ElectronicCats/PWNCUBE/ground-station/pwnsatc3/app/static/assets/Tapa-Body.stl

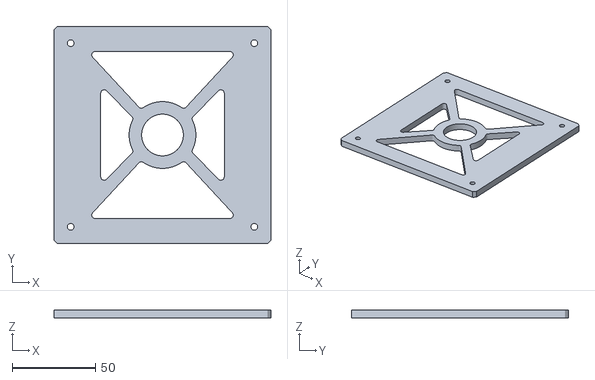
[picture p4: CAD file, 2026-04-01]
ground-station/pwnsatc3/app/static/assets/Tapa-Body.stl
130.0 x 130.0 x 5.00
