ElectronicCats/PWNCUBE/hardware/Battery_Board/3D/SAMTEC_SMA-J-P-H-ST-EM1.STEP

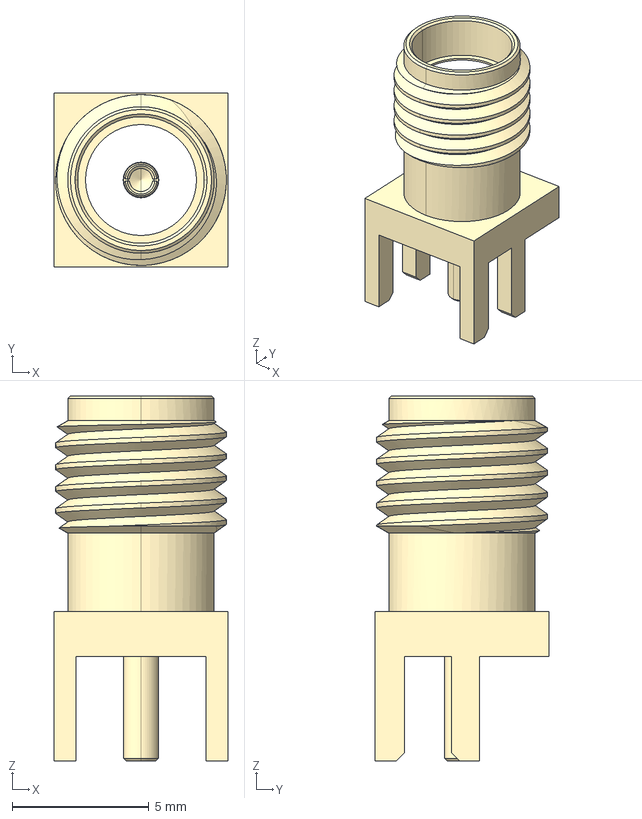
[picture p5: CAD file, 2026-02-04]
hardware/Battery_Board/3D/SAMTEC_SMA-J-P-H-ST-EM1.STEP
6.35 x 6.35 x 13.3 mm
