ElectronicCats/PWNCUBE/hardware/PWNSAT/3D/antenna_915Mhz-antenna_915Mhz.step

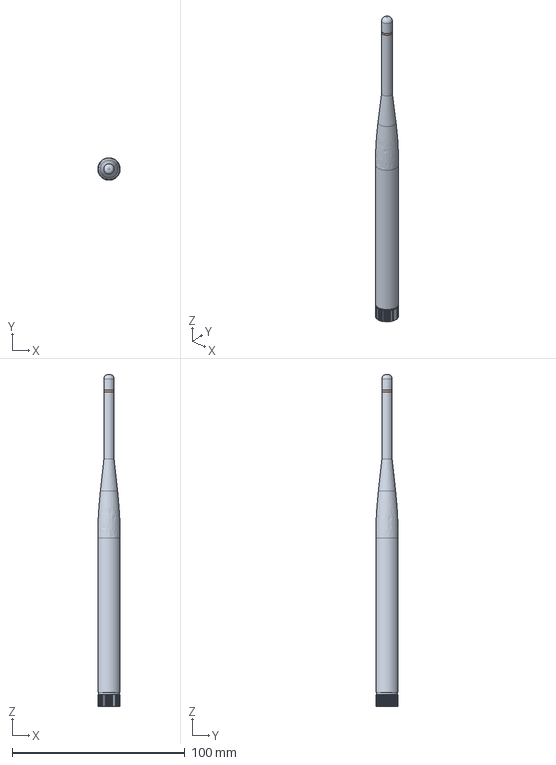
[picture p6: CAD file, 2026-02-04]
hardware/PWNSAT/3D/antenna_915Mhz-antenna_915Mhz.step
13.0 x 13.0 x 192.0 mm
