ElectronicCats/PWNCUBE/hardware/Sensor_Board/3D/USB4105-GF-A.stp

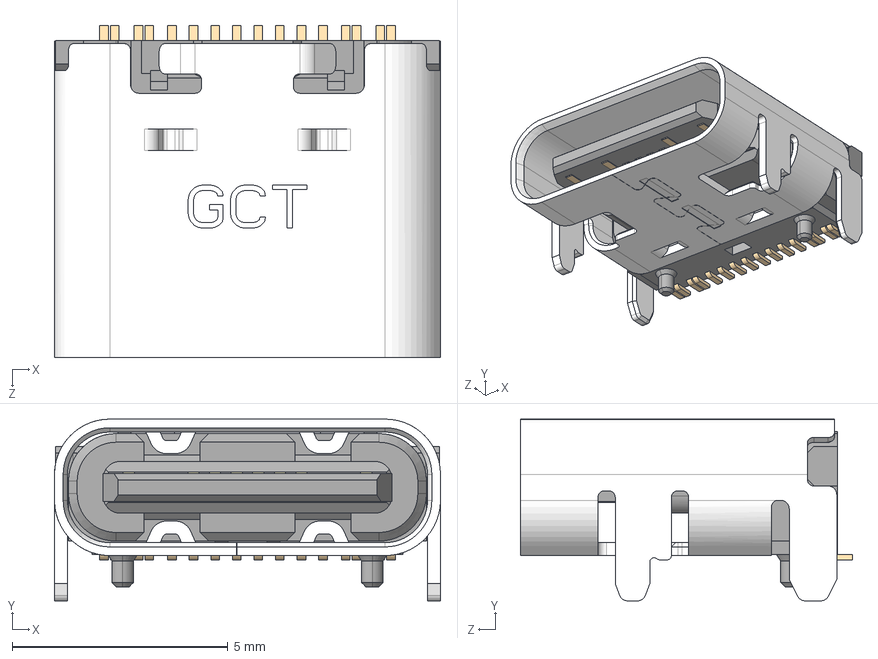
[picture p7: CAD file, 2026-02-04]
hardware/Sensor_Board/3D/USB4105-GF-A.stp
8.94 x 4.21 x 7.70 mm
HSG_默认
