ElectronicCats/PWNCUBE/hardware/Battery_Board/3D/TS-1088R-02526.STEP

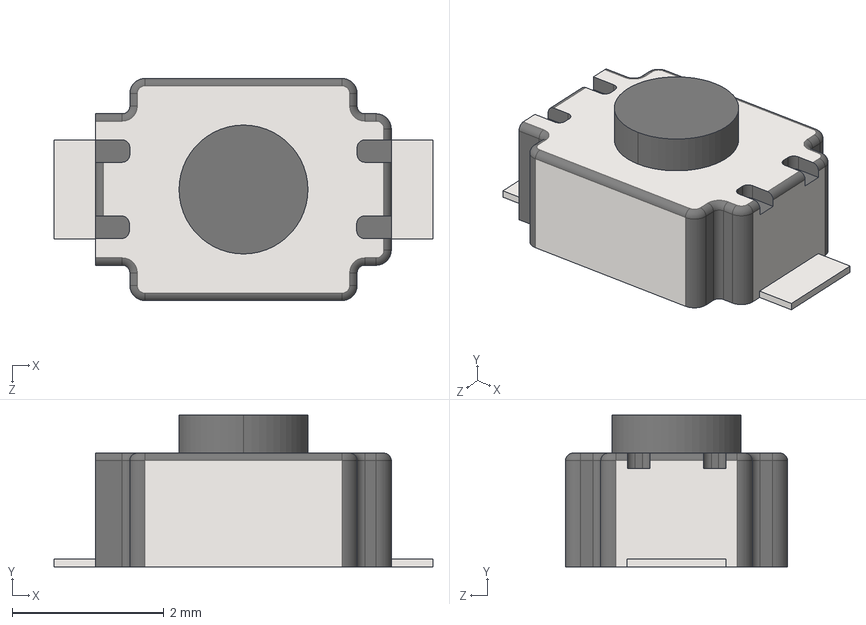
[picture p8: CAD file, 2026-02-04]
hardware/Battery_Board/3D/TS-1088R-02526.STEP
5.00 x 2.00 x 2.93 mm
