ElectronicCats/PWNCUBE/hardware/PWNSAT/3D/0900PC15A0036E--3DModel-STEP-56544.STEP

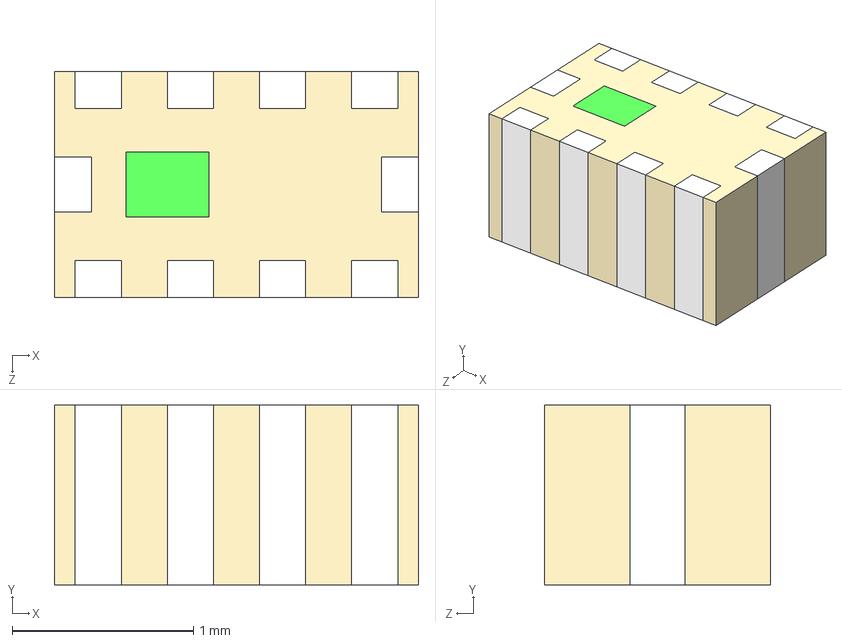
[picture p9: CAD file, 2026-02-04]
hardware/PWNSAT/3D/0900PC15A0036E--3DModel-STEP-56544.STEP
2.01 x 0.991 x 1.24 mm
