ElectronicCats/PWNCUBE/hardware/PWNSAT/3D/CMUSB661022B.stp

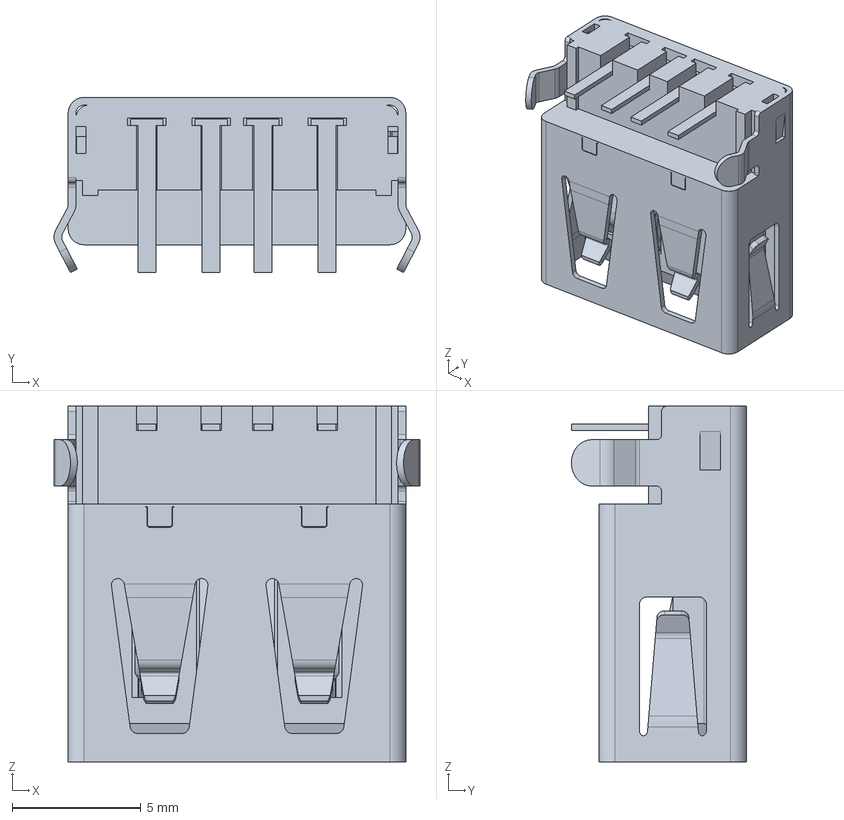
[picture p10: CAD file, 2026-02-04]
hardware/PWNSAT/3D/CMUSB661022B.stp
14.2 x 6.80 x 13.8 mm
