ElectronicCats/PWNCUBE/hardware/PWNSAT/3D/User Library-qfn-128.STEP

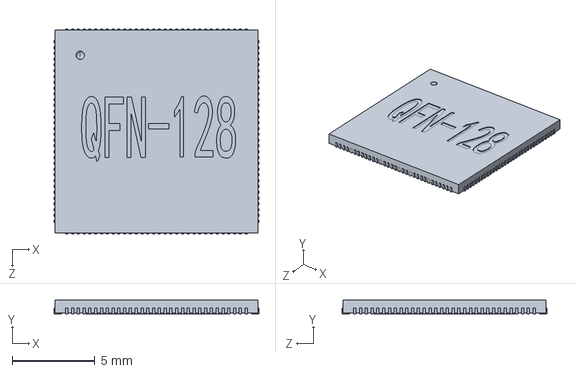
[picture p11: CAD file, 2026-02-04]
hardware/PWNSAT/3D/User Library-qfn-128.STEP
12.4 x 0.85 x 12.4 mm
