ElectronicCats/PWNCUBE/hardware/PWNSAT/3D/W25Q01JVZEIQ.STEP

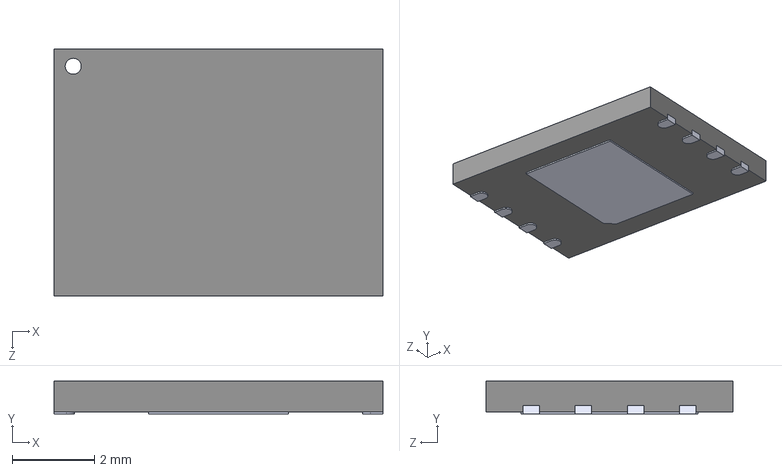
[picture p12: CAD file, 2026-02-04]
hardware/PWNSAT/3D/W25Q01JVZEIQ.STEP
8.00 x 0.8 x 6.00 mm
