ElectronicCats/PWNCUBE/hardware/PWNSAT/3D/1001-001-01000.igs

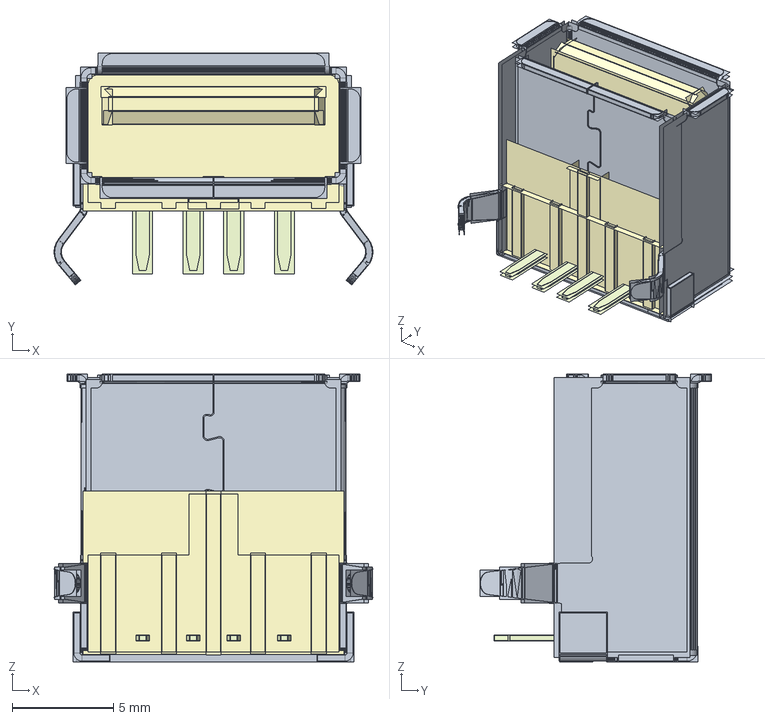
[picture p13: CAD file, 2026-02-04]
hardware/PWNSAT/3D/1001-001-01000.igs
15.8 x 11.5 x 14.2 mm
