ElectronicCats/PWNCUBE/hardware/PWNSAT/PWNSAT.kicad_pcb

## KiCad design hardware/PWNSAT/PWNSAT.kicad_pcb (2026-03-17)

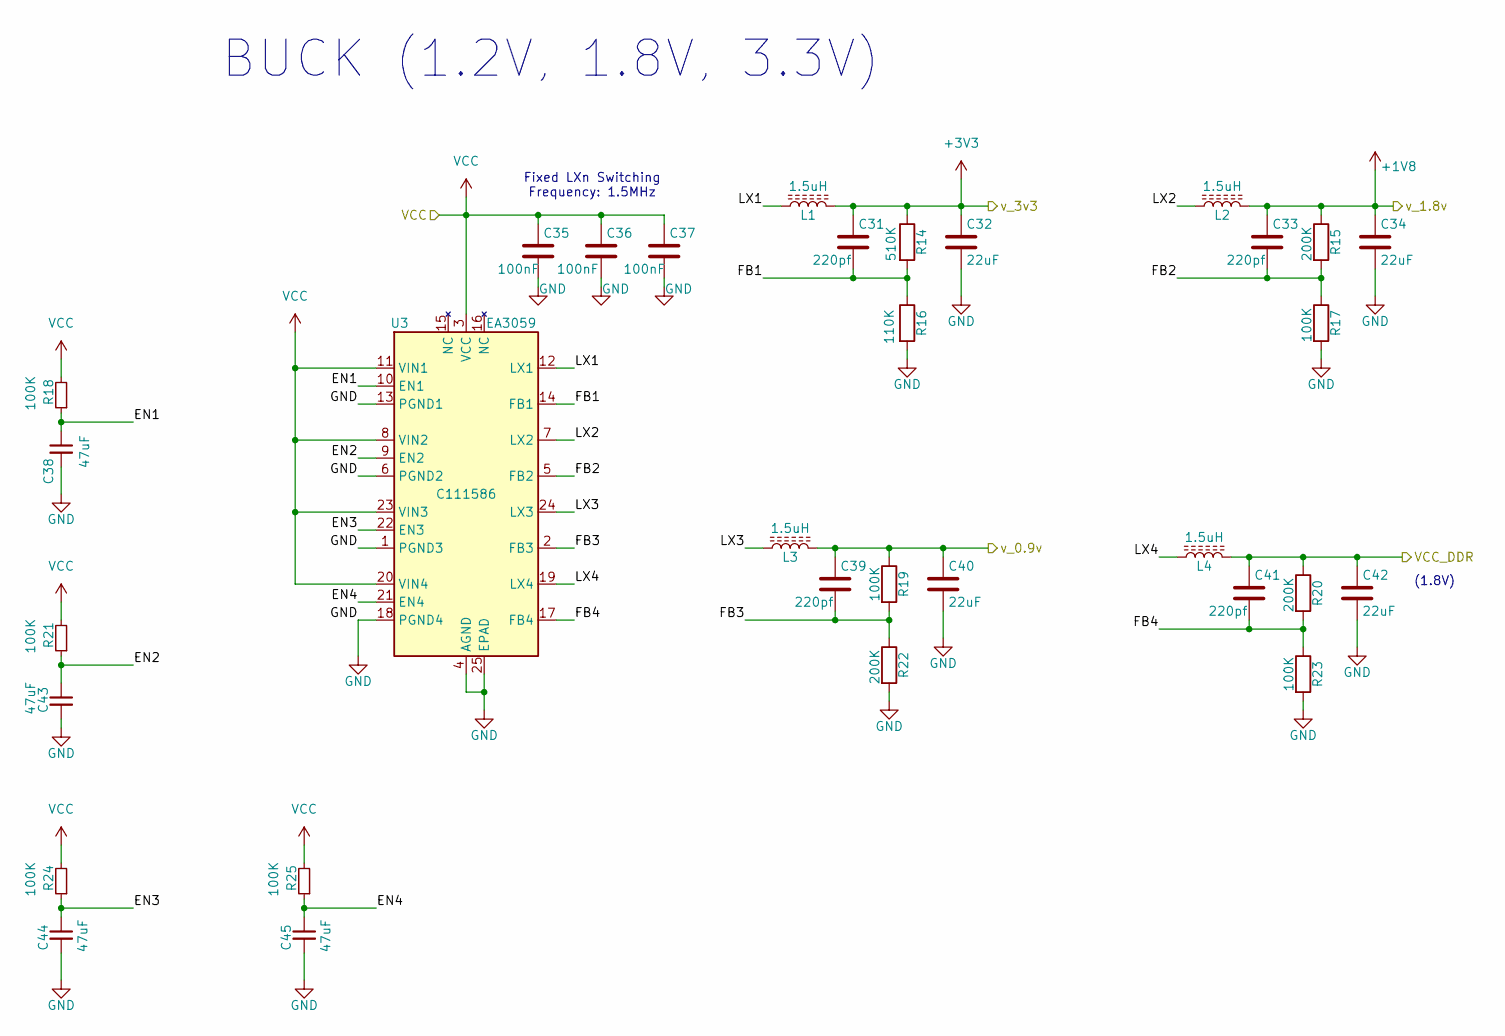
[picture p14: schematic power_supply.kicad_sch, PWNCube]

Parts:
C31, C33, C39, C41: 220pf; C_0402_1005Metric_Pad0.74x0.62mm_HandSolder; LCSC# C327000
C32, C34, C40, C42: 22uF; C_0402_1005Metric; LCSC# C415703
C35, C36, C37: 100nF; C_0402_1005Metric_Pad0.74x0.62mm_HandSolder; LCSC# C56392
C38, C43, C44, C45: 47uF; C_0603_1608Metric; LCSC# C140782
L1, L2, L3, L4: 1.5uH; L_1008_2520Metric; LCSC# C7427193
R14: 510K; R_0402_1005Metric_Pad0.72x0.64mm_HandSolder; LCSC# C365024
R15, R20, R22: 200K; R_0402_1005Metric_Pad0.72x0.64mm_HandSolder; LCSC# C364966
R16: 110K; R_0402_1005Metric_Pad0.72x0.64mm_HandSolder; LCSC# C854086
R17, R18, R19, R21, R23, R24, R25: 100K; R_0402_1005Metric_Pad0.72x0.64mm_HandSolder; LCSC# C844674
U3: EA3059; VQFN-24-1EP_4x4mm_P0.5mm_EP2.5x2.5mm; LCSC# C111586

Connections:
+1V8: C33.1, C34.1, L2.2, R15.1; also elsewhere on the board
+3V3: C31.1, C32.1, L1.2, R14.1; also elsewhere on the board
/core/VCC_DDR: C41.1, C42.1, L4.2, R20.1; also elsewhere on the board
/core/VDD_ARM: C39.1, C40.1, L3.2, R19.1; also elsewhere on the board
/power_supply/EN1: C38.1, R18.1, U3.10 (EN1)
/power_supply/EN2: C43.1, R21.1, U3.9 (EN2)
/power_supply/EN3: C44.1, R24.1, U3.22 (EN3)
/power_supply/EN4: C45.1, R25.1, U3.21 (EN4)
/power_supply/FB1: C31.2, R14.2, R16.1, U3.14 (FB1)
/power_supply/FB2: C33.2, R15.2, R17.1, U3.5 (FB2)
/power_supply/FB3: C39.2, R19.2, R22.1, U3.2 (FB3)
/power_supply/FB4: C41.2, R20.2, R23.1, U3.17 (FB4)
/power_supply/LX1: L1.1, U3.12 (LX1)
/power_supply/LX2: L2.1, U3.7 (LX2)
/power_supply/LX3: L3.1, U3.24 (LX3)
/power_supply/LX4: L4.1, U3.19 (LX4)
GND: C32.2, C34.2, C35.2, C36.2, C37.2, C38.2, C40.2, C42.2, C43.2, C44.2, C45.2, R16.2, R17.2, R22.2, R23.2, U3.1 (PGND3), U3.4 (AGND), U3.6 (PGND2), U3.13 (PGND1), U3.18 (PGND4), U3.25 (EPAD); also elsewhere on the board
VCC: C35.1, C36.1, C37.1, R18.2, R21.2, R24.2, R25.2, U3.3 (VCC), U3.8 (VIN2), U3.11 (VIN1), U3.20 (VIN4), U3.23 (VIN3); also elsewhere on the board

Notes on the sheet:
BUCK (1.2V, 1.8V, 3.3V)
Fixed LXn Switching Frequency: 1.5MHz
(1.8V)

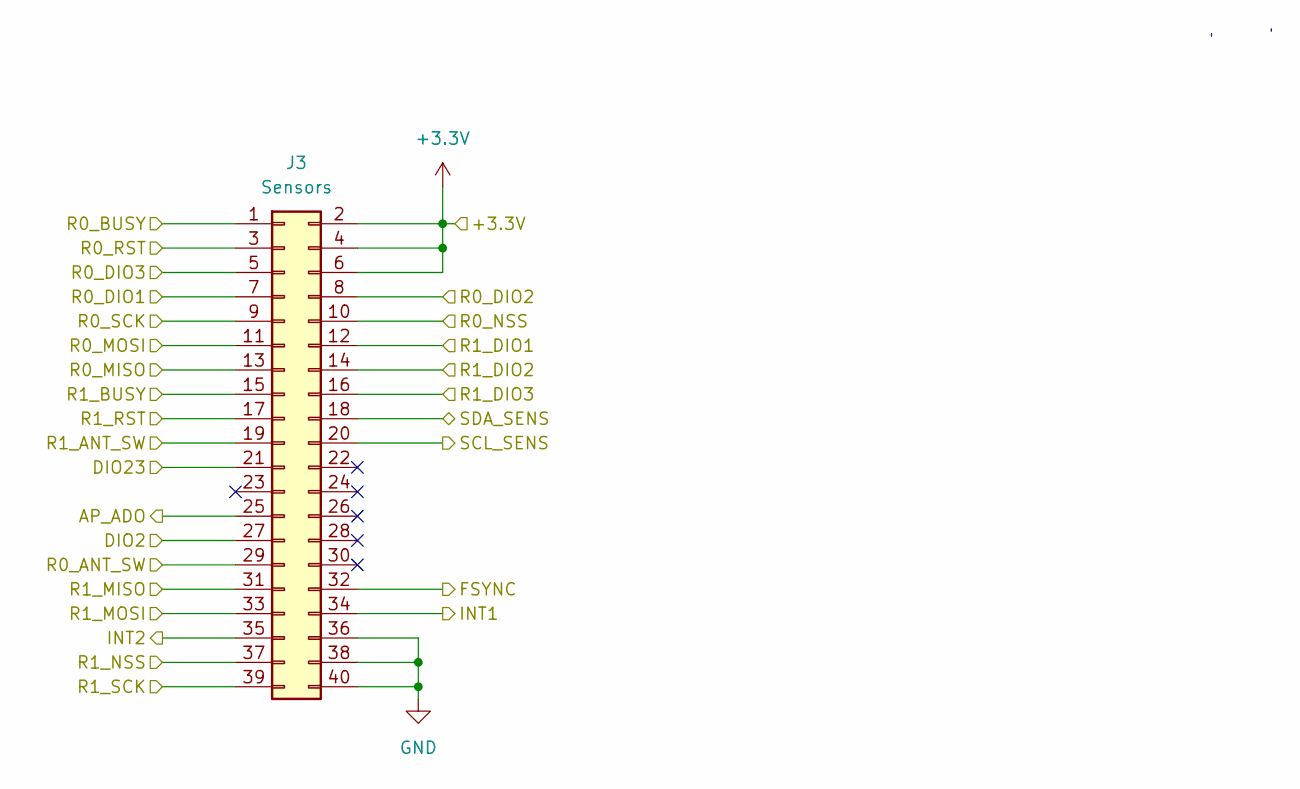
[picture p15: schematic sensor.kicad_sch, PWNCube]

Parts:
J3: Sensors; PinHeader_2x20_P2.54mm_Vertical; LCSC# C7501249

Connections:
+3.3V: J3.2, J3.4, J3.6; also elsewhere on the board
/Sensor/AP_ADO: J3.25; also elsewhere on the board
/Sensor/DIO2: J3.27; also elsewhere on the board
/Sensor/DIO23: J3.21; also elsewhere on the board
/Sensor/FSYNC: J3.32; also elsewhere on the board
/Sensor/INT1: J3.34; also elsewhere on the board
/Sensor/INT2: J3.35; also elsewhere on the board
/Sensor/R0_ANT_SW: J3.29; also elsewhere on the board
/Sensor/R0_BUSY: J3.1; also elsewhere on the board
/Sensor/R0_DIO1: J3.7; also elsewhere on the board
/Sensor/R0_DIO2: J3.8; also elsewhere on the board
/Sensor/R0_DIO3: J3.5; also elsewhere on the board
/Sensor/R0_MISO: J3.13; also elsewhere on the board
/Sensor/R0_MOSI: J3.11; also elsewhere on the board
/Sensor/R0_NSS: J3.10; also elsewhere on the board
/Sensor/R0_RST: J3.3; also elsewhere on the board
/Sensor/R0_SCK: J3.9; also elsewhere on the board
/Sensor/R1_ANT_SW: J3.19; also elsewhere on the board
/Sensor/R1_BUSY: J3.15; also elsewhere on the board
/Sensor/R1_DIO1: J3.12; also elsewhere on the board
/Sensor/R1_DIO2: J3.14; also elsewhere on the board
/Sensor/R1_DIO3: J3.16; also elsewhere on the board
/Sensor/R1_MISO: J3.31; also elsewhere on the board
/Sensor/R1_MOSI: J3.33; also elsewhere on the board
/Sensor/R1_NSS: J3.37; also elsewhere on the board
/Sensor/R1_RST: J3.17; also elsewhere on the board
/Sensor/R1_SCK: J3.39; also elsewhere on the board
/Sensor/SCL_SENS: J3.20; also elsewhere on the board
/Sensor/SDA_SENS: J3.18; also elsewhere on the board
GND: J3.36, J3.38, J3.40; also elsewhere on the board

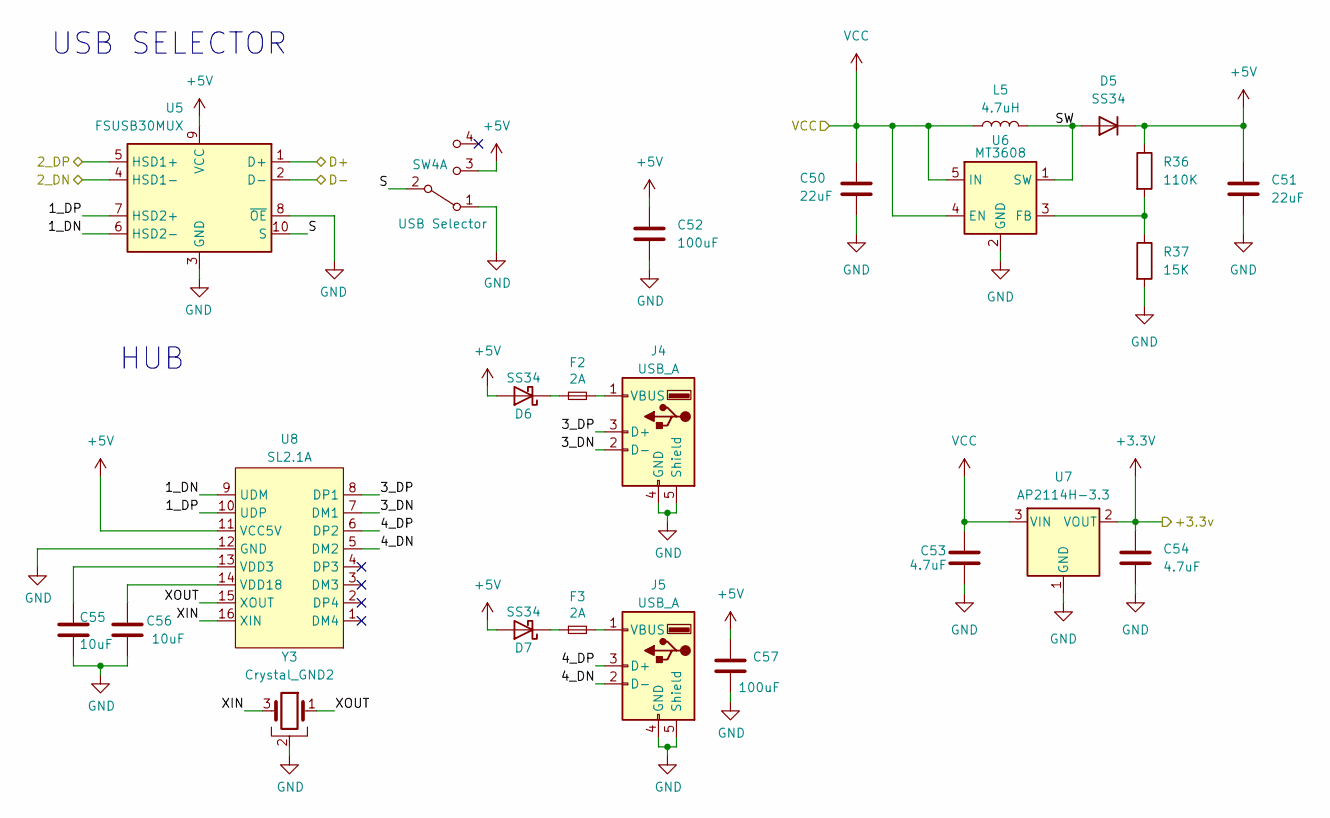
[picture p16: schematic USB_Selector.kicad_sch, PWNCube]

Parts:
C50, C51: 22uF; C_0402_1005Metric; LCSC# C415703
C52, C57: 100uF; C_0805_2012Metric; LCSC# C141660
C53, C54: 4.7uF; C_0402_1005Metric; LCSC# C368809
C55, C56: 10uF; C_0603_1608Metric; LCSC# C96446
D5, D6, D7: SS34; D_SMA; LCSC# C908680
F2, F3: 2A; Fuse_0603_1608Metric; LCSC# C41380229
J4, J5: USB_A; USB_A_Connfly_DS1095; LCSC# C2345
L5: 4.7uH; LQH5BPN; LCSC# C520334
R36: 110K; R_0603_1608Metric; LCSC# C326736
R37: 15K; R_0603_1608Metric; LCSC# C2989599
SW4: USB Selector; SW_Slide_SPDT_Angled_CK_OS102011MA1Q; LCSC# C393937
U5: FSUSB30MUX; IC_FSUSB42UMX; LCSC# C42370490
U6: MT3608; SOT-23-6; LCSC# C2932326
U7: AP2114H-3.3; SOT-223-3_TabPin2; LCSC# C150716
U8: SL2.1A; SO-16_3.9x9.9mm_P1.27mm; LCSC# C192893
Y3: Crystal_GND2; Crystal_SMD_3225-4Pin_3.2x2.5mm; LCSC# C133334

Connections:
+3.3V: C54.1, U7.2 (VOUT); also elsewhere on the board
+5V: C51.1, C52.1, C57.1, D5.1 (K), D6.2 (A), D7.2 (A), R36.1, SW4.3 (C), U5.9 (VCC), U8.11 (VCC5V)
/Source_Connector/2_DN: U5.4 (HSD1-); also elsewhere on the board
/Source_Connector/2_DP: U5.5 (HSD1+); also elsewhere on the board
/USB_Selector/1_DN: U5.6 (HSD2-), U8.9 (UDM)
/USB_Selector/1_DP: U5.7 (HSD2+), U8.10 (UDP)
/USB_Selector/3_DN: J4.2 (D-), U8.7 (DM1)
/USB_Selector/3_DP: J4.3 (D+), U8.8 (DP1)
/USB_Selector/4_DN: J5.2 (D-), U8.5 (DM2)
/USB_Selector/4_DP: J5.3 (D+), U8.6 (DP2)
/USB_Selector/D+: U5.1 (D+); also elsewhere on the board
/USB_Selector/D-: U5.2 (D-); also elsewhere on the board
/USB_Selector/S: SW4.2 (B), U5.10 (S)
/USB_Selector/SW: D5.2 (A), L5.2, U6.1 (SW)
/USB_Selector/XIN: U8.16 (XIN), Y3.3
/USB_Selector/XOUT: U8.15 (XOUT), Y3.1
GND: C50.2, C51.2, C52.2, C53.2, C54.2, C55.2, C56.1, C57.2, J4.4 (GND), J4.5 (Shield), J5.4 (GND), J5.5 (Shield), R37.2, SW4.1 (A), U5.3 (GND), U5.8 (~OE), U6.2 (GND), U7.1 (GND), U8.12 (GND), Y3.2, Y3.4; also elsewhere on the board
unnamed: D6.1 (K), F2.1
unnamed: D7.1 (K), F3.1
unnamed: F2.2, J4.1 (VBUS)
unnamed: F3.2, J5.1 (VBUS)
unnamed: R36.2, R37.1, U6.3 (FB)
unnamed: C55.1, U8.13 (VDD3)
unnamed: C56.2, U8.14 (VDD18)
VCC: C50.1, C53.1, L5.1, U6.4 (EN), U6.5 (IN), U7.3 (VIN); also elsewhere on the board

Notes on the sheet:
HUB
USB SELECTOR

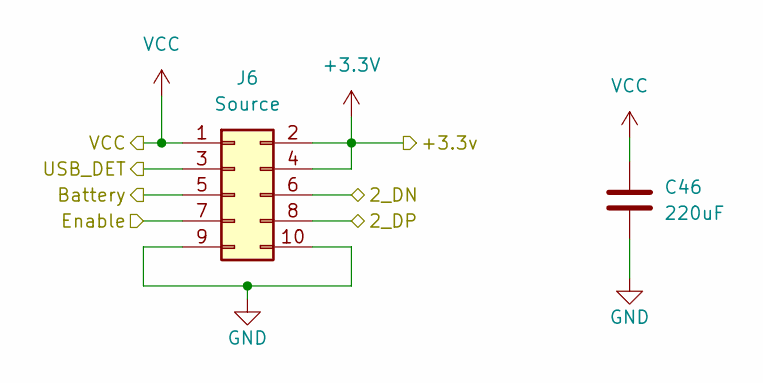
[picture p17: schematic Source_Connector.kicad_sch, PWNCube]

Parts:
C46: 220uF; C_1206_3216Metric
J6: Source; PinHeader_2x05_P2.54mm_Vertical; LCSC# C7501191

Connections:
+3.3V: J6.2, J6.4; also elsewhere on the board
/Source_Connector/2_DN: J6.6; also elsewhere on the board
/Source_Connector/2_DP: J6.8; also elsewhere on the board
/Source_Connector/Battery: J6.5; also elsewhere on the board
/Source_Connector/Enable: J6.7; also elsewhere on the board
/Source_Connector/USB_DET: J6.3; also elsewhere on the board
GND: C46.2, J6.9, J6.10; also elsewhere on the board
VCC: C46.1, J6.1; also elsewhere on the board

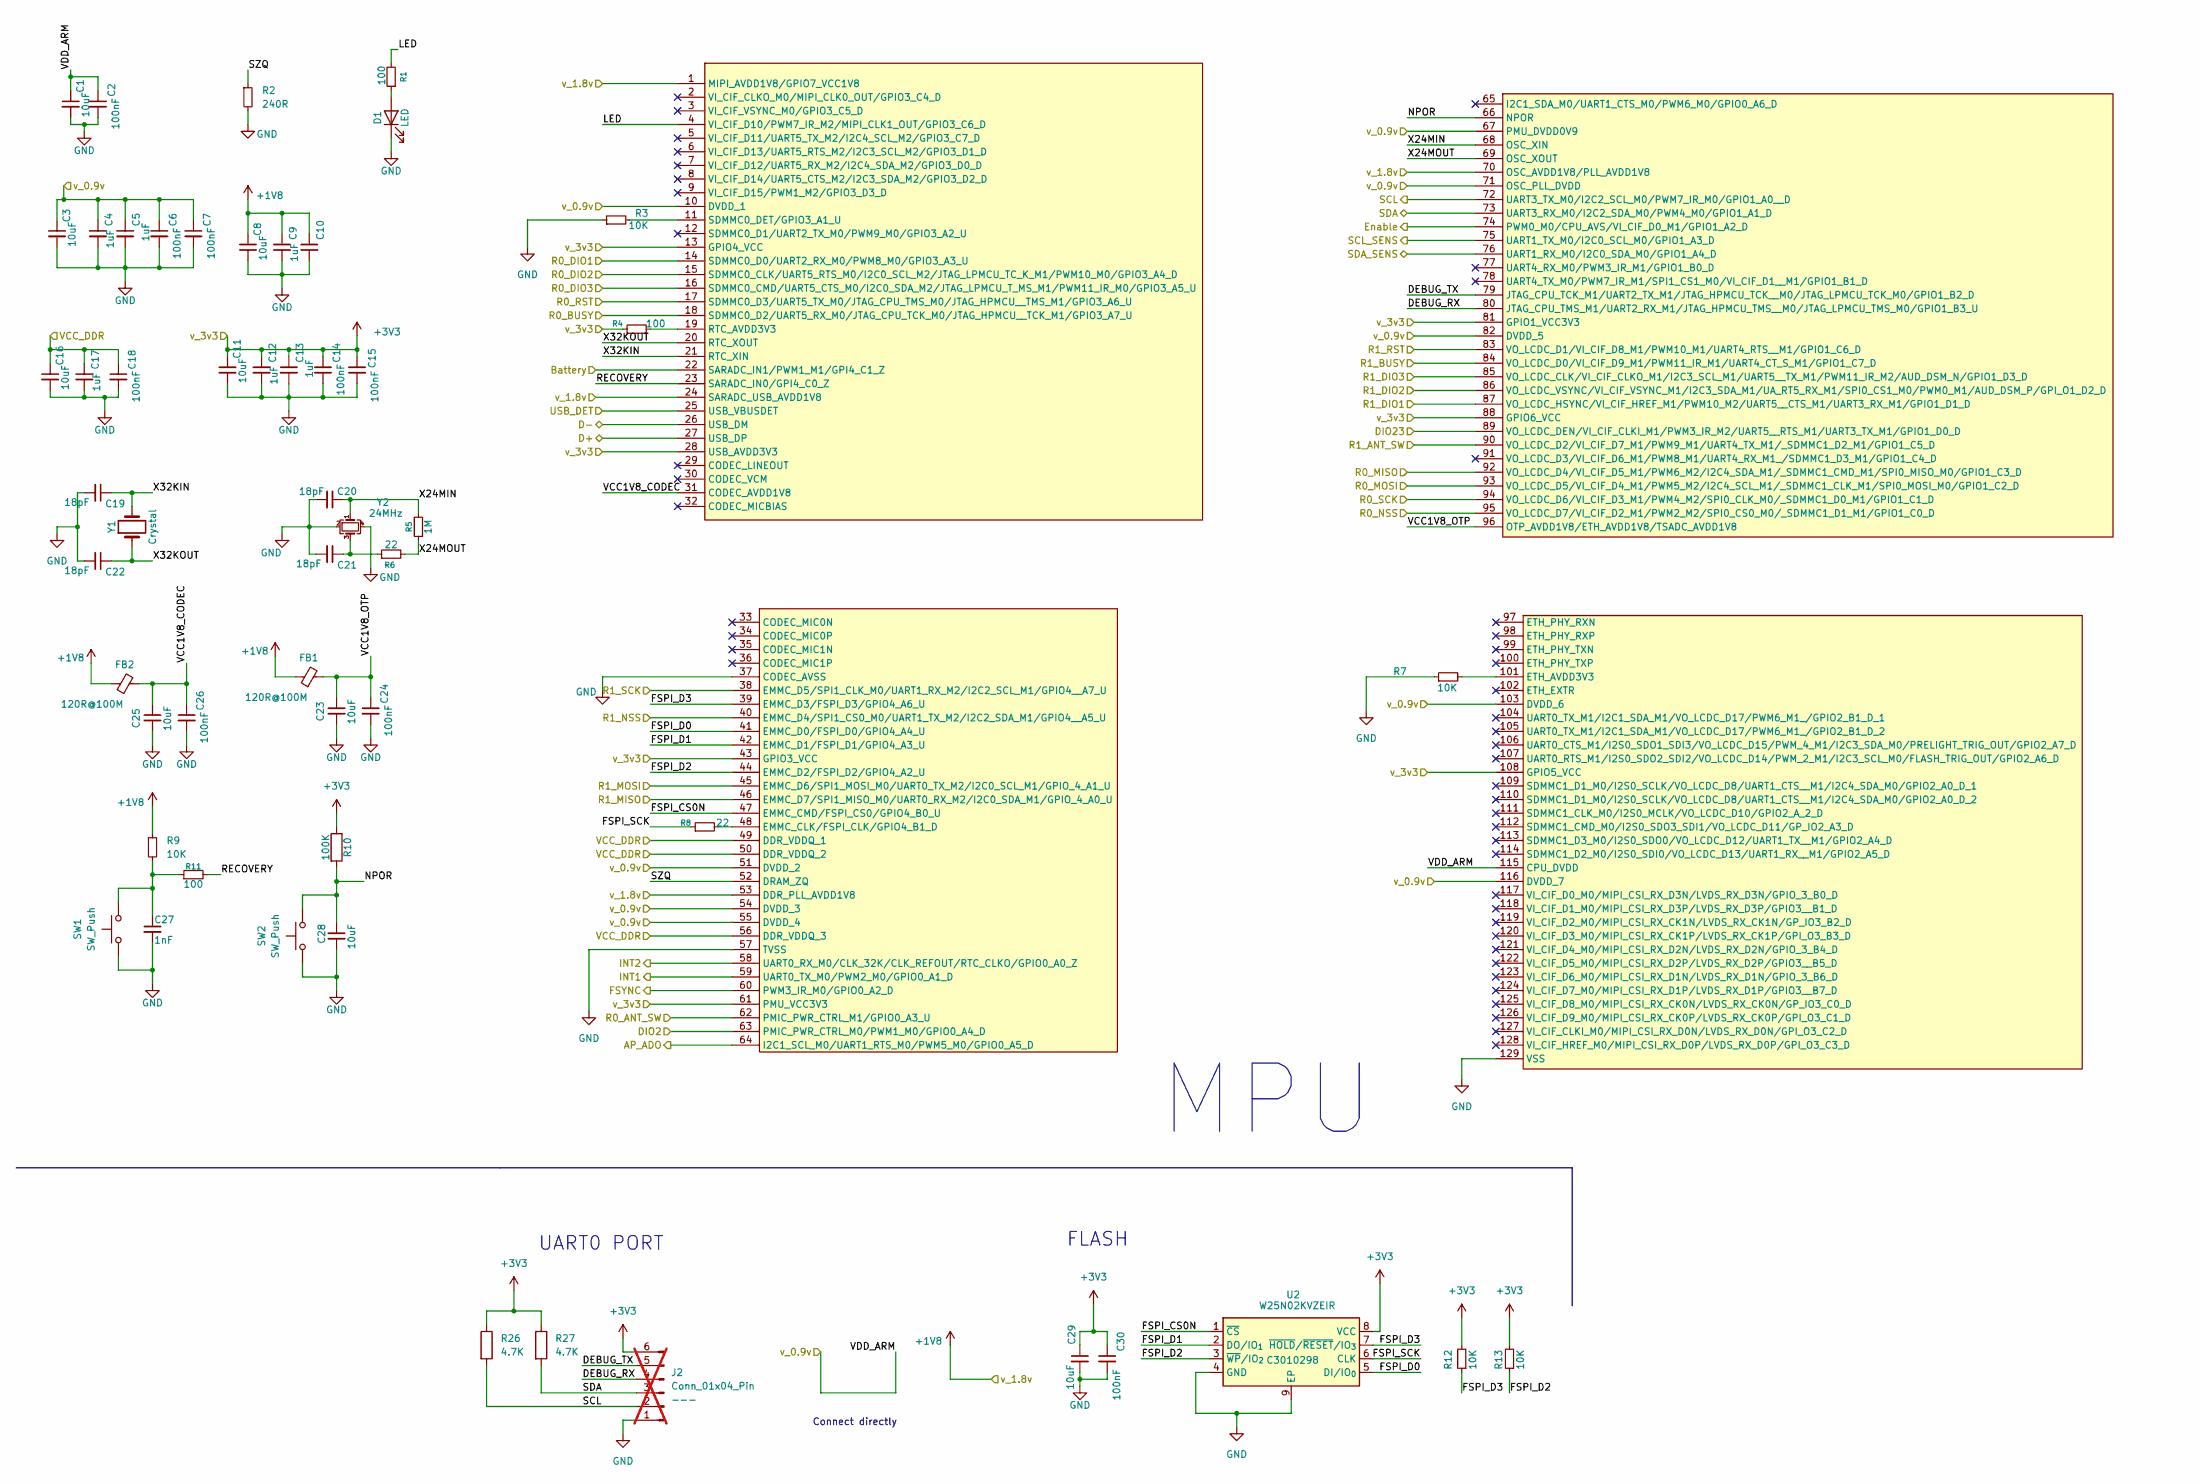
[picture p18: schematic untitled.kicad_sch, PWNCube]

Parts:
C1, C3, C8, C11, C16, C23, C25, C28, C29: 10uF; C_0603_1608Metric; LCSC# C96446
C2, C6, C7, C14, C15, C18, C24, C26, C30: 100nF; C_0402_1005Metric_Pad0.74x0.62mm_HandSolder; LCSC# C56392
C4, C5, C9, C10, C12, C13, C17: 1uF; C_0402_1005Metric_Pad0.74x0.62mm_HandSolder; LCSC# C52923
C19, C20, C21, C22: 18pF; C_0402_1005Metric_Pad0.74x0.62mm_HandSolder; LCSC# C161534
C27: 1nF; C_0402_1005Metric_Pad0.74x0.62mm_HandSolder; LCSC# C189467
D1: LED; LED_0603_1608Metric; LCSC# C375573
FB1, FB2: 120R@100M; L_0603_1608Metric; LCSC# C14709
J2: Conn_01x04_Pin; PinHeader_1x06_P2.54mm_Vertical; LCSC# ---; not fitted
R1, R4, R11: 100; R_0603_1608Metric; LCSC# C253328
R2: 240R; R_0402_1005Metric_Pad0.72x0.64mm_HandSolder; LCSC# C728568
R3, R7, R9, R12, R13: 10K; R_0402_1005Metric_Pad0.72x0.64mm_HandSolder; LCSC# C2759535
R5: 1M; R_0402_1005Metric_Pad0.72x0.64mm_HandSolder; LCSC# C131492
R6, R8: 22; R_0603_1608Metric; LCSC# C313374
R10: 100K; R_0402_1005Metric_Pad0.72x0.64mm_HandSolder; LCSC# C844674
R26, R27: 4.7K; R_0402_1005Metric_Pad0.72x0.64mm_HandSolder; LCSC# C400631
SW1, SW2: SW_Push; TS1088R02026; LCSC# C455281
U1: RV1106G3; LCSC# C5328706
U2: W25N02KVZEIR; WSON-8-1EP_8x6mm_P1.27mm_EP3.4x4.3mm; LCSC# C3010298
Y1: Crystal; Crystal_SMD_3215-2Pin_3.2x1.5mm; LCSC# C620155
Y2: 24MHz; Crystal_SMD_3225-4Pin_3.2x2.5mm; LCSC# C70590

Connections:
+1V8: C8.1, C9.1, C10.1, FB1.1, FB2.1, R9.1, U1.1 (MIPI_AVDD1V8/GPIO7_VCC1V8), U1.24 (SARADC_USB_AVDD1V8), U1.53 (DDR_PLL_AVDD1V8), U1.70 (OSC_AVDD1V8/PLL_AVDD1V8); also elsewhere on the board
+3V3: C11.1, C12.1, C13.1, C14.1, C15.1, C29.1, C30.1, J2.6, R4.1, R10.1, R12.2, R13.2, R26.1, R27.1, U1.13 (GPIO4_VCC), U1.28 (USB_AVDD3V3), U1.43 (GPIO3_VCC), U1.61 (PMU_VCC3V3), U1.81 (GPIO1_VCC3V3), U1.88 (GPIO6_VCC), U1.108 (GPIO5_VCC), U2.8 (VCC); also elsewhere on the board
/Sensor/AP_ADO: U1.64 (I2C1_SCL_M0/UART1_RTS_M0/PWM5_M0/GPIO0_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); also elsewhere on the board
/Sensor/DIO2: U1.63 (PMIC_PWR_CTRL_M0/PWM1_M0/GPIO0_A4_D); also elsewhere on the board
/Sensor/DIO23: U1.89 (VO_LCDC_DEN/VI_CIF_CLKI_M1/PWM3_IR_M2/U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); also elsewhere on the board
/Sensor/FSYNC: U1.60 (PWM3_IR_M0/GPIO0_A2_D); also elsewhere on the board
/Sensor/INT1: U1.59 (UART0_TX_M0/PWM2_M0/GPIO0_A1_D); also elsewhere on the board
/Sensor/INT2: U1.58 (UART0_RX_M0/CLK_32K/CLK_REFOUT/RTC_CLKO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); also elsewhere on the board
/Sensor/R0_ANT_SW: U1.62 (PMIC_PWR_CTRL_M1/GPIO0_A3_U); also elsewhere on the board
/Sensor/R0_BUSY: U1.18 (SDMMC0_D2/UART5_RX_M0/JTAG_CPU_TCK_M0/J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); also elsewhere on the board
/Sensor/R0_DIO1: U1.14 (SDMMC0_D0/UART2_RX_M0/PWM8_M0/GPIO3_A3_U); also elsewhere on the board
/Sensor/R0_DIO2: U1.15 (SDMMC0_CLK/UART5_RTS_M0/I2C0_SCL_M2/JTA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); also elsewhere on the board
/Sensor/R0_DIO3: U1.16 (SDMMC0_CMD/UART5_CTS_M0/I2C0_SDA_M2/JTA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); also elsewhere on the board
/Sensor/R0_MISO: U1.92 (VO_LCDC_D4/VI_CIF_D5_M1/PWM6_M2/I2C4_SD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); also elsewhere on the board
/Sensor/R0_MOSI: U1.93 (VO_LCDC_D5/VI_CIF_D4_M1/PWM5_M2/I2C4_SC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); also elsewhere on the board
/Sensor/R0_NSS: U1.95 (VO_LCDC_D7/VI_CIF_D2_M1/PWM2_M2/SPI0_CS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); also elsewhere on the board
/Sensor/R0_RST: U1.17 (SDMMC0_D3/UART5_TX_M0/JTAG_CPU_TMS_M0/J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); also elsewhere on the board
/Sensor/R0_SCK: U1.94 (VO_LCDC_D6/VI_CIF_D3_M1/PWM4_M2/SPI0_CL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); also elsewhere on the board
/Sensor/R1_ANT_SW: U1.90 (VO_LCDC_D2/VI_CIF_D7_M1/PWM9_M1/UART4_T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); also elsewhere on the board
/Sensor/R1_BUSY: U1.84 (VO_LCDC_D0/VI_CIF_D9_M1/PWM11_IR_M1/UAR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); also elsewhere on the board
/Sensor/R1_DIO1: U1.87 (VO_LCDC_HSYNC/VI_CIF_HREF_M1/PWM10_M2/U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); also elsewhere on the board
/Sensor/R1_DIO2: U1.86 (VO_LCDC_VSYNC/VI_CIF_VSYNC_M1/I2C3_SDA_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); also elsewhere on the board
/Sensor/R1_DIO3: U1.85 (VO_LCDC_CLK/VI_CIF_CLKO_M1/I2C3_SCL_M1/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); also elsewhere on the board
/Sensor/R1_MISO: U1.46 (EMMC_D7/SPI1_MISO_M0/UART0_RX_M2/I2C0_S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); also elsewhere on the board
/Sensor/R1_MOSI: U1.45 (EMMC_D6/SPI1_MOSI_M0/UART0_TX_M2/I2C0_S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); also elsewhere on the board
/Sensor/R1_NSS: U1.40 (EMMC_D4/SPI1_CS0_M0/UART1_TX_M2/I2C2_SD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); also elsewhere on the board
/Sensor/R1_RST: U1.83 (VO_LCDC_D1/VI_CIF_D8_M1/PWM10_M1/UART4_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); also elsewhere on the board
/Sensor/R1_SCK: U1.38 (EMMC_D5/SPI1_CLK_M0/UART1_RX_M2/I2C2_SC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); also elsewhere on the board
/Sensor/SCL_SENS: U1.75 (UART1_TX_M0/I2C0_SCL_M0/GPIO1_A3_D); also elsewhere on the board
/Sensor/SDA_SENS: U1.76 (UART1_RX_M0/I2C0_SDA_M0/GPIO1_A4_D); also elsewhere on the board
/Source_Connector/Battery: U1.22 (SARADC_IN1/PWM1_M1/GPI4_C1_Z); also elsewhere on the board
/Source_Connector/Enable: U1.74 (PWM0_M0/CPU_AVS/VI_CIF_D0_M1/GPIO1_A2_D); also elsewhere on the board
/Source_Connector/USB_DET: U1.25 (USB_VBUSDET); also elsewhere on the board
/USB_Selector/D+: U1.27 (USB_DP); also elsewhere on the board
/USB_Selector/D-: U1.26 (USB_DM); also elsewhere on the board
/core/DEBUG_RX: J2.4, U1.80 (JTAG_CPU_TMS_M1/UART2_RX_M1/JTAG_HPMCU_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)
/core/DEBUG_TX: J2.5, U1.79 (JTAG_CPU_TCK_M1/UART2_TX_M1/JTAG_HPMCU_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)
/core/FSPI_CS0N: U1.47 (EMMC_CMD/FSPI_CS0/GPIO4_B0_U), U2.1 (~CS)
/core/FSPI_D0: U1.41 (EMMC_D0/FSPI_D0/GPIO4_A4_U), U2.5 (DI/IO_{0})
/core/FSPI_D1: U1.42 (EMMC_D1/FSPI_D1/GPIO4_A3_U), U2.2 (DO/IO_{1})
/core/FSPI_D2: R13.1, U1.44 (EMMC_D2/FSPI_D2/GPIO4_A2_U), U2.3 (~WP/IO_{2})
/core/FSPI_D3: R12.1, U1.39 (EMMC_D3/FSPI_D3/GPIO4_A6_U), U2.7 (~HOLD/~RESET/IO_{3})
/core/FSPI_SCK: R8.1, U2.6 (CLK)
/core/LED: R1.2, U1.4 (VI_CIF_D10/PWM7_IR_M2/MIPI_CLK1_OUT/GPI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)
/core/NPOR: C28.1, R10.2, SW2.2, U1.66 (NPOR)
/core/RECOVERY: R11.2, U1.23 (SARADC_IN0/GPI4_C0_Z)
/core/SCL: J2.2, R26.2, U1.72 (UART3_TX_M0/I2C2_SCL_M0/PWM7_IR_M0/GPIO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)
/core/SDA: J2.3, R27.2, U1.73 (UART3_RX_M0/I2C2_SDA_M0/PWM4_M0/GPIO1_A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)
/core/SZQ: R2.1, U1.52 (DRAM_ZQ)
/core/VCC1V8_CODEC: C25.1, C26.1, FB2.2, U1.31 (CODEC_AVDD1V8)
/core/VCC1V8_OTP: C23.1, C24.1, FB1.2, U1.96 (OTP_AVDD1V8/ETH_AVDD1V8/TSADC_AVDD1V8)
/core/VCC_DDR: C16.1, C17.1, C18.1, U1.49 (DDR_VDDQ_1), U1.50 (DDR_VDDQ_2), U1.56 (DDR_VDDQ_3); also elsewhere on the board
/core/VDD_ARM: C1.1, C2.1, C3.1, C4.1, C5.1, C6.1, C7.1, U1.10 (DVDD_1), U1.51 (DVDD_2), U1.54 (DVDD_3), U1.55 (DVDD_4), U1.67 (PMU_DVDD0V9), U1.71 (OSC_PLL_DVDD), U1.82 (DVDD_5), U1.103 (DVDD_6), U1.115 (CPU_DVDD), U1.116 (DVDD_7); also elsewhere on the board
/core/X24MIN: C20.1, R5.1, U1.68 (OSC_XIN), Y2.1
/core/X24MOUT: R5.2, R6.2, U1.69 (OSC_XOUT)
/core/X32KIN: C19.1, U1.21 (RTC_XIN), Y1.2
/core/X32KOUT: C22.1, U1.20 (RTC_XOUT), Y1.1
GND: C1.2, C2.2, C3.2, C4.2, C5.2, C6.2, C7.2, C8.2, C9.2, C10.2, C11.2, C12.2, C13.2, C14.2, C15.2, C16.2, C17.2, C18.2, C19.2, C20.2, C21.2, C22.2, C23.2, C24.2, C25.2, C26.2, C27.2, C28.2, C29.2, C30.2, D1.1 (K), J2.1, R2.2, R3.1, R7.1, SW1.1, SW2.1, U1.37 (CODEC_AVSS), U1.57 (TVSS), U1.129 (VSS), U2.4 (GND), U2.9 (EP), Y2.2, Y2.4; also elsewhere on the board
unnamed: C21.1, R6.1, Y2.3
unnamed: C27.1, R9.2, R11.1, SW1.2
unnamed: D1.2 (A), R1.1
unnamed: R4.2, U1.19 (RTC_AVDD3V3)
unnamed: R3.2, U1.11 (SDMMC0_DET/GPIO3_A1_U)
unnamed: R8.2, U1.48 (EMMC_CLK/FSPI_CLK/GPIO4_B1_D)
unnamed: R7.2, U1.101 (ETH_AVDD3V3)

Notes on the sheet:
FLASH
UART0 PORT
MPU
Connect directly

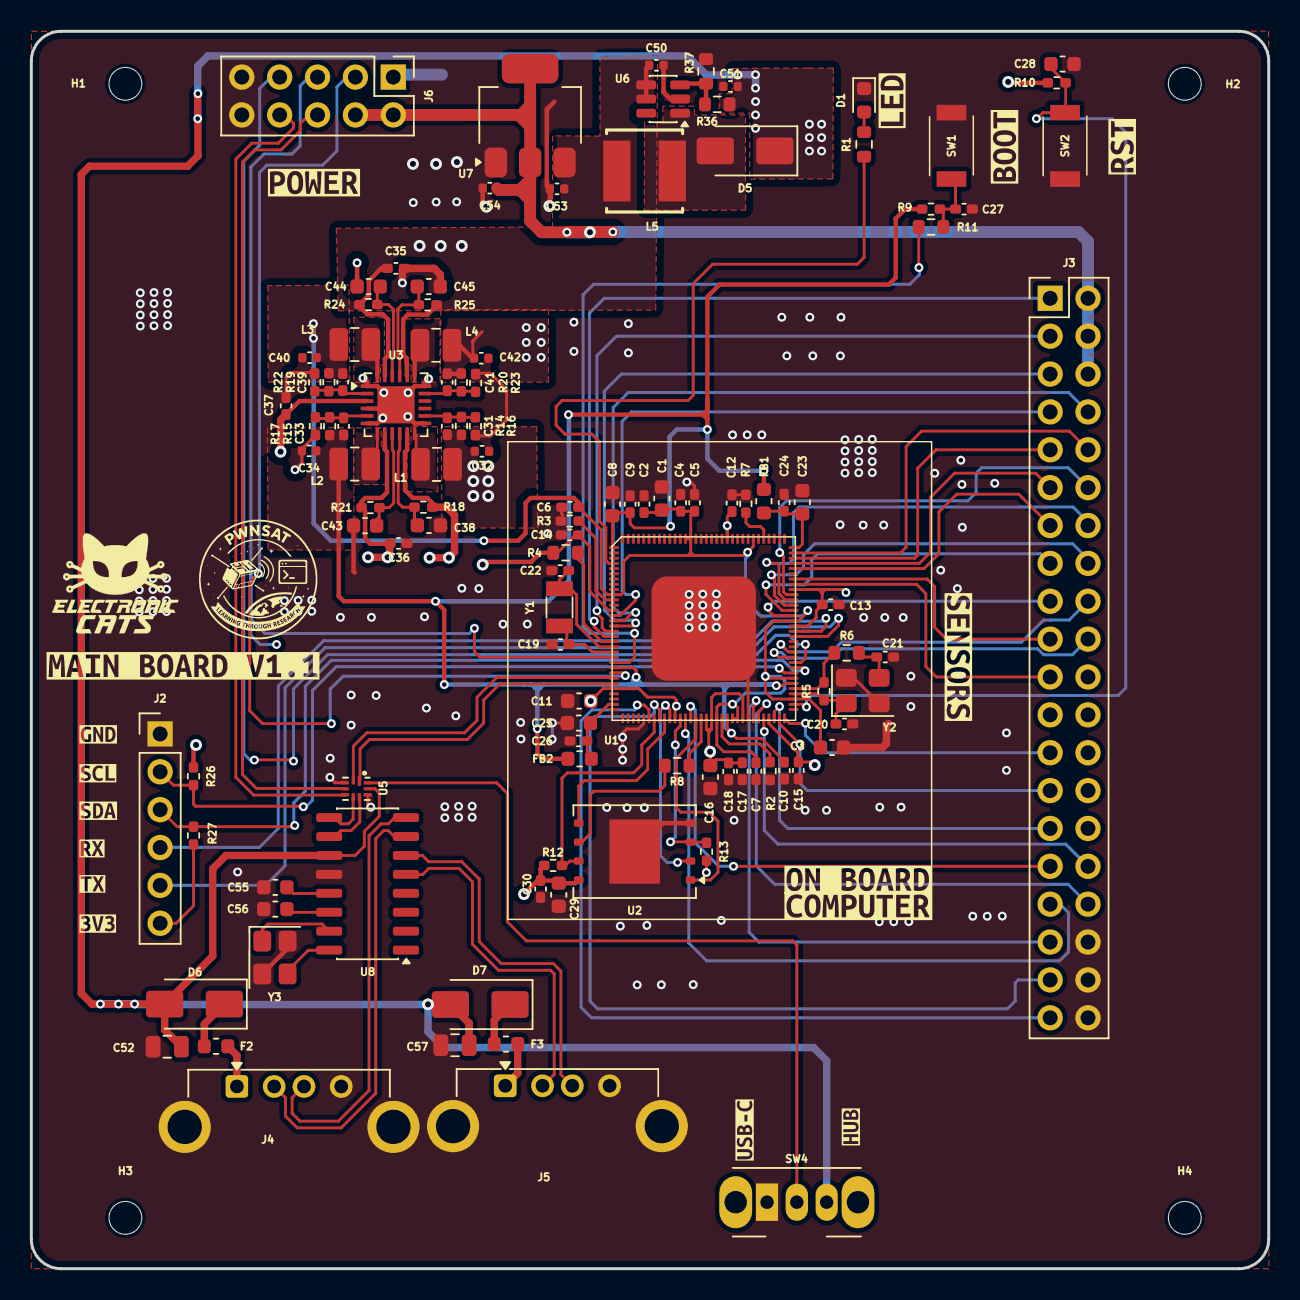
[picture p19: board PWNSAT.kicad_pcb from above]

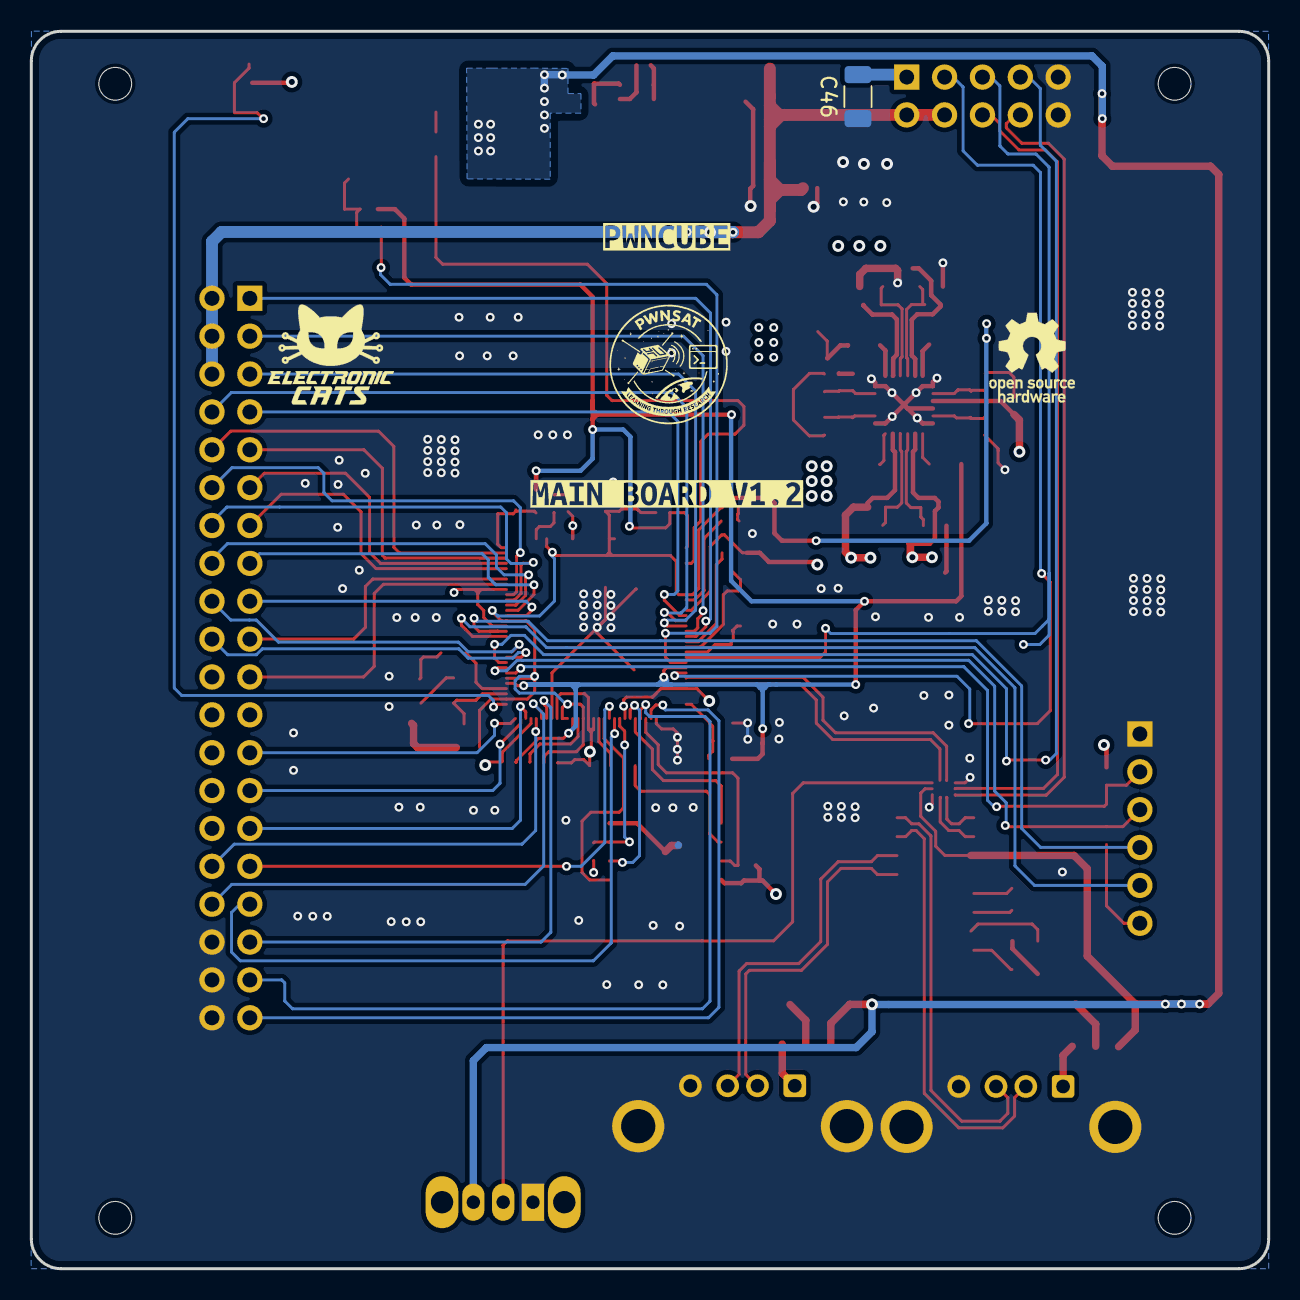
[picture p20: board PWNSAT.kicad_pcb from below]

Board: 4 copper layers, 83.0 x 83.0 mm, 136 parts (3 on the bottom side), 99 nets.

Other parts of the board:
H1, H2, H3, H4: MountingHole; MountingHole_2.2mm_M2
kibuzzard-69B43A9C: G***; kibuzzard-69B43A9C
kibuzzard-69B883B0: G***; kibuzzard-69B883B0
kibuzzard-6989FAE0: G***; kibuzzard-6989FAE0
kibuzzard-6989FAEE: G***; kibuzzard-6989FAEE
kibuzzard-698516AC: G***; kibuzzard-698516AC
kibuzzard-698516D4: G***; kibuzzard-698516D4
kibuzzard-698516F5: G***; kibuzzard-698516F5
kibuzzard-698517BF: G***; kibuzzard-698517BF
kibuzzard-698517CD: G***; kibuzzard-698517CD
kibuzzard-698517E4: G***; kibuzzard-698517E4
kibuzzard-698517F0: G***; kibuzzard-698517F0
kibuzzard-698615E5: G***; kibuzzard-698615E5
kibuzzard-6985157B: G***; kibuzzard-6985157B
kibuzzard-6985168F: G***; kibuzzard-6985168F
kibuzzard-6986164F: G***; kibuzzard-6986164F
kibuzzard-69851805: G***; kibuzzard-69851805
kibuzzard-69851812: G***; kibuzzard-69851812
kibuzzard-69861606: G***; kibuzzard-69861606
