ElectronicCats/PWNCUBE/hardware/Sensor_Board/Sensor_Board.kicad_pcb

## KiCad design hardware/Sensor_Board/Sensor_Board.kicad_pcb (2026-02-09)

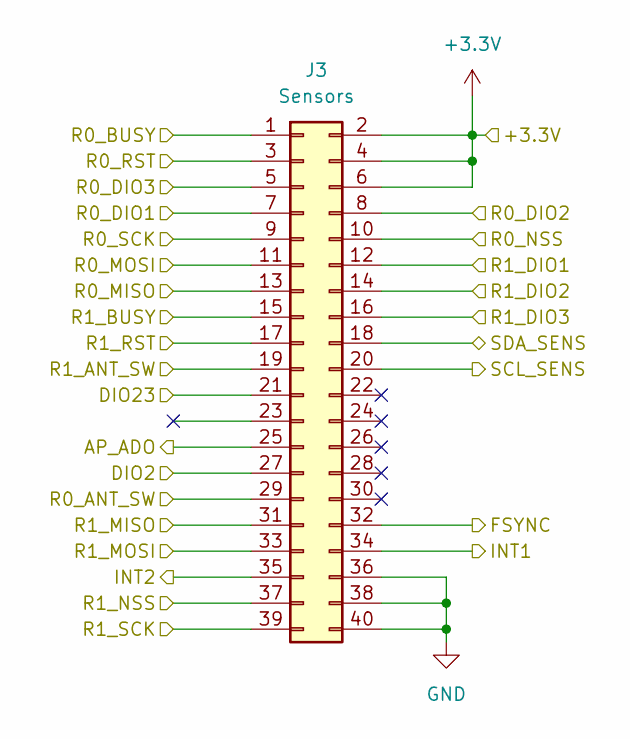
[picture p21: schematic Inputs_Connectors.kicad_sch]

Parts:
J3: Sensors; PinHeader_2x20_P2.54mm_Vertical; LCSC# C7501249

Connections:
+3.3V: J3.2, J3.4, J3.6; also elsewhere on the board
/Inputs_Connectors/AP_ADO: J3.25; also elsewhere on the board
/Inputs_Connectors/DIO2: J3.27; also elsewhere on the board
/Inputs_Connectors/DIO23: J3.21; also elsewhere on the board
/Inputs_Connectors/FSYNC: J3.32; also elsewhere on the board
/Inputs_Connectors/INT1: J3.34; also elsewhere on the board
/Inputs_Connectors/INT2: J3.35; also elsewhere on the board
/Inputs_Connectors/R0_ANT_SW: J3.29; also elsewhere on the board
/Inputs_Connectors/R0_BUSY: J3.1; also elsewhere on the board
/Inputs_Connectors/R0_DIO1: J3.7; also elsewhere on the board
/Inputs_Connectors/R0_DIO3: J3.5; also elsewhere on the board
/Inputs_Connectors/R0_MISO: J3.13; also elsewhere on the board
/Inputs_Connectors/R0_MOSI: J3.11; also elsewhere on the board
/Inputs_Connectors/R0_NSS: J3.10; also elsewhere on the board
/Inputs_Connectors/R0_RST: J3.3; also elsewhere on the board
/Inputs_Connectors/R0_SCK: J3.9; also elsewhere on the board
/Inputs_Connectors/R1_ANT_SW: J3.19; also elsewhere on the board
/Inputs_Connectors/R1_BUSY: J3.15; also elsewhere on the board
/Inputs_Connectors/R1_DIO1: J3.12; also elsewhere on the board
/Inputs_Connectors/R1_DIO3: J3.16; also elsewhere on the board
/Inputs_Connectors/R1_MISO: J3.31; also elsewhere on the board
/Inputs_Connectors/R1_MOSI: J3.33; also elsewhere on the board
/Inputs_Connectors/R1_NSS: J3.37; also elsewhere on the board
/Inputs_Connectors/R1_RST: J3.17; also elsewhere on the board
/Inputs_Connectors/R1_SCK: J3.39; also elsewhere on the board
/Inputs_Connectors/SCL_SENS: J3.20; also elsewhere on the board
/Inputs_Connectors/SDA_SENS: J3.18; also elsewhere on the board
/Sensors/R0_DIO2: J3.8; also elsewhere on the board
/Sensors/R1_DIO2: J3.14; also elsewhere on the board
GND: J3.36, J3.38, J3.40; also elsewhere on the board
