ElectronicCats/PWNCUBE/hardware/Sensor_Board/Sensor_Board.kicad_pcb

## KiCad design hardware/Sensor_Board/Sensor_Board.kicad_pcb (continued)

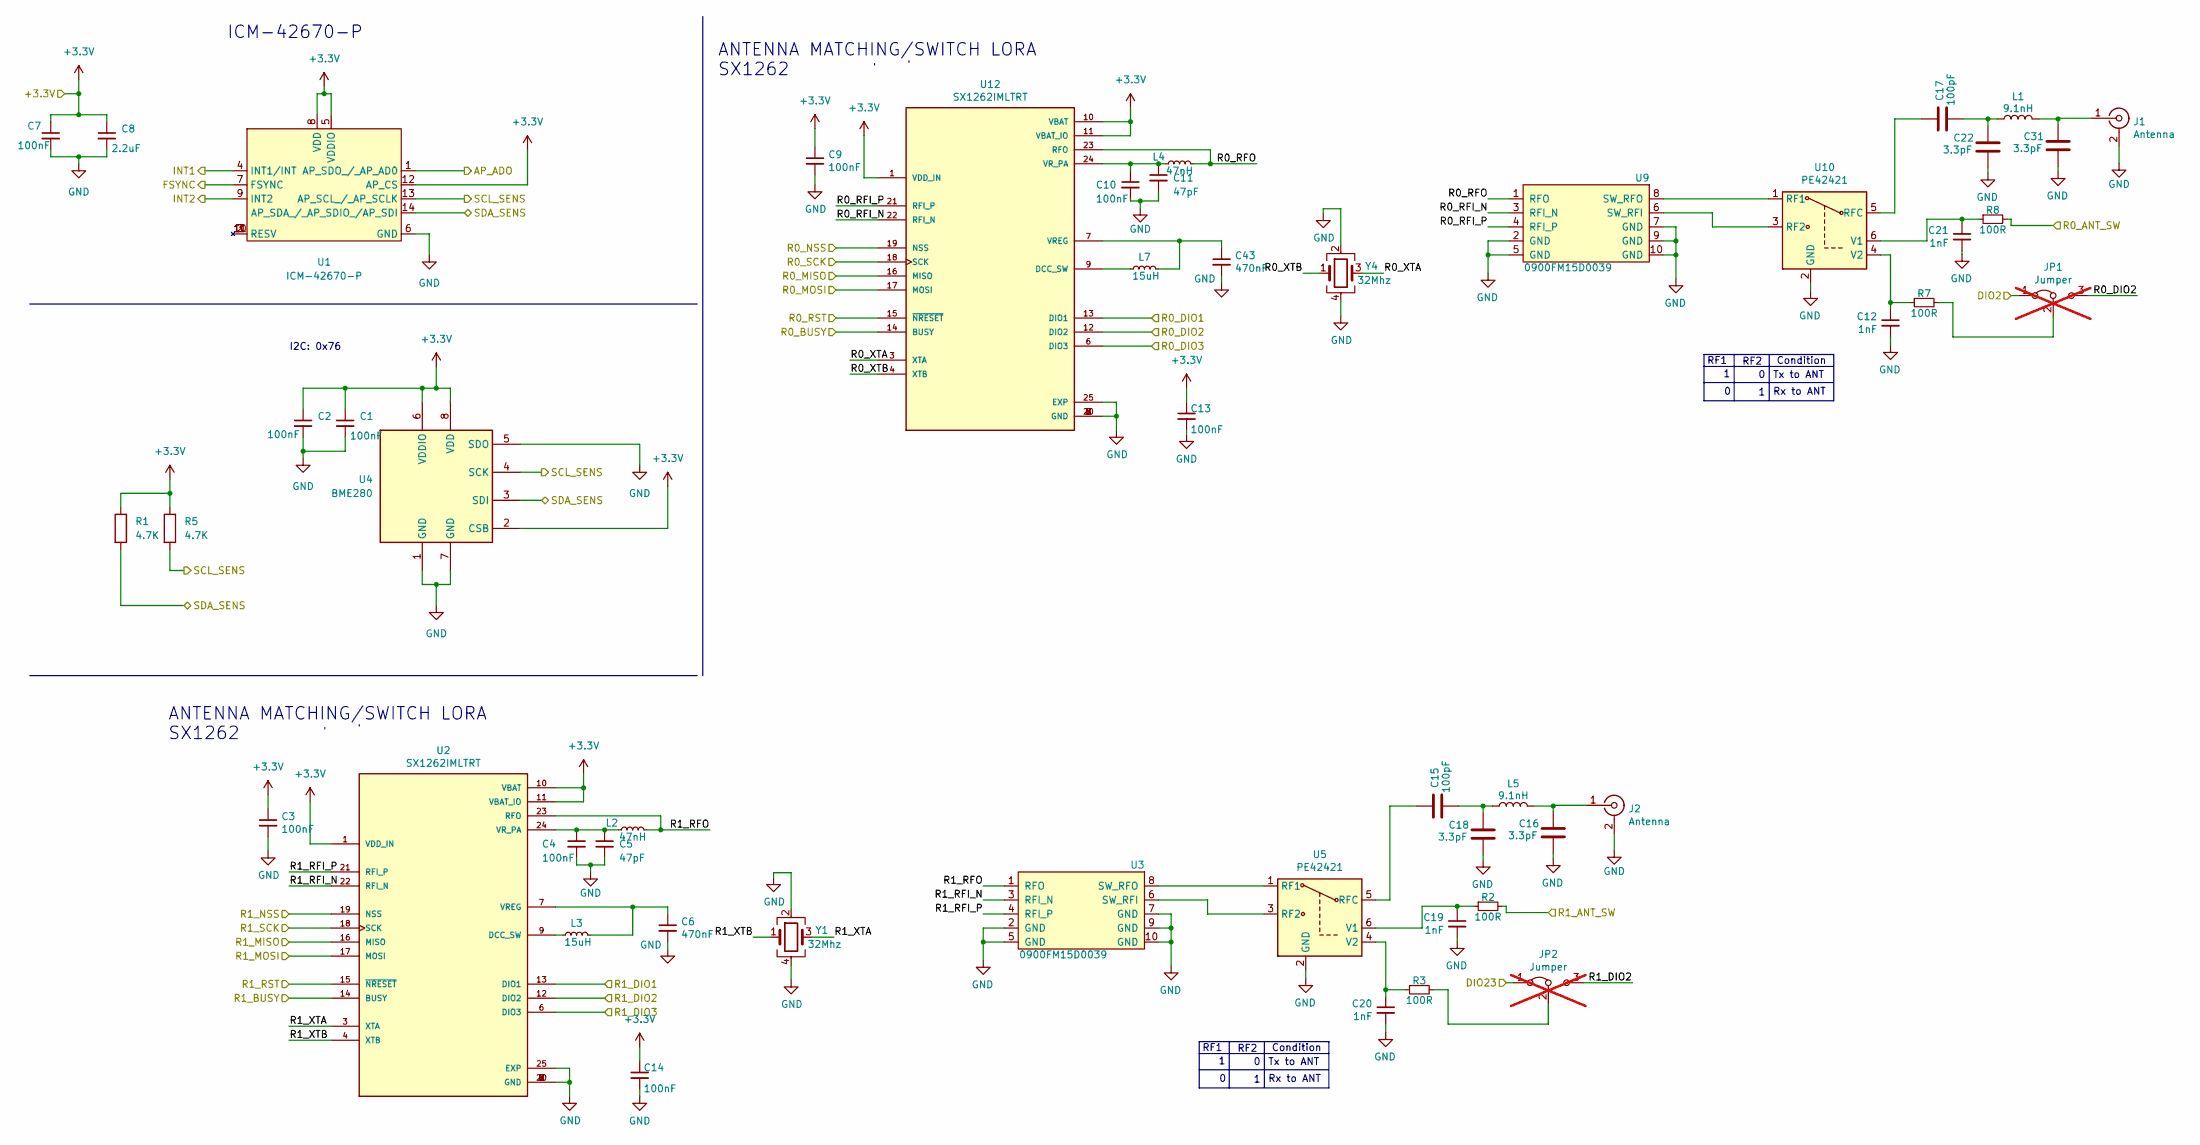
[picture p22: schematic Sensors.kicad_sch]

Parts:
C1, C2, C3, C4, C7, C9, C10, C13, C14: 100nF; C_0402_1005Metric; LCSC# C56392
C5, C11: 47pF; C_0402_1005Metric; LCSC# C437519
C6, C43: 470nF; C_0402_1005Metric; LCSC# C47339
C8: 2.2uF; C_0402_1005Metric; LCSC# C170151
C12, C19, C20, C21: 1nF; C_0402_1005Metric; LCSC# C76947
C15, C17: 100pF; C_0402_1005Metric; LCSC# C541374
C16, C18, C22, C31: 3.3pF; C_0402_1005Metric; LCSC# C1565
J1, J2: Antenna; SMA_EDGE; LCSC# C530661
JP1, JP2: Jumper; SolderJumper-3_P1.3mm_Bridged12_RoundedPad1.0x1.5mm_NumberL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; LCSC# ---; not fitted
L1, L5: 9.1nH; L_0603_1608Metric; LCSC# C395094
L2, L4: 47nH; L_0603_1608Metric; LCSC# C578001
L3, L7: 15uH; L_0603_1608Metric; LCSC# C2885870
R1, R5: 4.7K; R_0402_1005Metric_Pad0.72x0.64mm_HandSolder; LCSC# C400631
R2, R3, R7, R8: 100R; R_0402_1005Metric; LCSC# C25076
U1: ICM-42670-P; LGA-14_3x2.5mm_P0.5mm_LayoutBorder3x4y; LCSC# C3288646
U2, U12: SX1262IMLTRT; QFN-24-1EP_4x4mm_P0.5mm_EP2.65x2.65mm; Mouser# 947-SX1262IMLTRT
U3, U9: 0900FM15D0039; 0900FM15D0039E; Mouser# 609-0900FM15D0039E
U4: BME280; Bosch_LGA-8_2.5x2.5mm_P0.65mm_ClockwisePinNumbering; LCSC# C92489
U5, U10: PE42421; SOT-363_SC-70-6; Mouser# 81-PE42421SCAA-Z; LCSC# C470893
Y1, Y4: 32Mhz; Crystal_SMD_2520-4Pin_2.5x2.0mm; LCSC# C255969

Connections:
+3.3V: C1.1, C2.1, C3.1, C7.1, C8.1, C9.1, C13.1, C14.1, R1.1, R5.1, U1.5 (VDDIO), U1.8 (VDD), U1.12 (AP_CS), U2.1 (VDD_IN), U2.10 (VBAT), U2.11 (VBAT_IO), U4.2 (CSB), U4.6 (VDDIO), U4.8 (VDD), U12.1 (VDD_IN), U12.10 (VBAT), U12.11 (VBAT_IO); also elsewhere on the board
/Inputs_Connectors/AP_ADO: U1.1 (AP_SDO_/_AP_AD0); also elsewhere on the board
/Inputs_Connectors/DIO2: JP1.1 (A); also elsewhere on the board
/Inputs_Connectors/DIO23: JP2.1 (A); also elsewhere on the board
/Inputs_Connectors/FSYNC: U1.7 (FSYNC); also elsewhere on the board
/Inputs_Connectors/INT1: U1.4 (INT1/INT); also elsewhere on the board
/Inputs_Connectors/INT2: U1.9 (INT2); also elsewhere on the board
/Inputs_Connectors/R0_ANT_SW: R8.2; also elsewhere on the board
/Inputs_Connectors/R0_BUSY: U12.14 (BUSY); also elsewhere on the board
/Inputs_Connectors/R0_DIO1: U12.13 (DIO1); also elsewhere on the board
/Inputs_Connectors/R0_DIO3: U12.6 (DIO3); also elsewhere on the board
/Inputs_Connectors/R0_MISO: U12.16 (MISO); also elsewhere on the board
/Inputs_Connectors/R0_MOSI: U12.17 (MOSI); also elsewhere on the board
/Inputs_Connectors/R0_NSS: U12.19 (NSS); also elsewhere on the board
/Inputs_Connectors/R0_RST: U12.15 (~NRESET); also elsewhere on the board
/Inputs_Connectors/R0_SCK: U12.18 (SCK); also elsewhere on the board
/Inputs_Connectors/R1_ANT_SW: R2.2; also elsewhere on the board
/Inputs_Connectors/R1_BUSY: U2.14 (BUSY); also elsewhere on the board
/Inputs_Connectors/R1_DIO1: U2.13 (DIO1); also elsewhere on the board
/Inputs_Connectors/R1_DIO3: U2.6 (DIO3); also elsewhere on the board
/Inputs_Connectors/R1_MISO: U2.16 (MISO); also elsewhere on the board
/Inputs_Connectors/R1_MOSI: U2.17 (MOSI); also elsewhere on the board
/Inputs_Connectors/R1_NSS: U2.19 (NSS); also elsewhere on the board
/Inputs_Connectors/R1_RST: U2.15 (~NRESET); also elsewhere on the board
/Inputs_Connectors/R1_SCK: U2.18 (SCK); also elsewhere on the board
/Inputs_Connectors/SCL_SENS: R5.2, U1.13 (AP_SCL_/_AP_SCLK), U4.4 (SCK); also elsewhere on the board
/Inputs_Connectors/SDA_SENS: R1.2, U1.14 (AP_SDA_/_AP_SDIO_/AP_SDI), U4.3 (SDI); also elsewhere on the board
/Sensors/R0_DIO2: JP1.3 (B), U12.12 (DIO2); also elsewhere on the board
/Sensors/R0_RFI_N: U9.3 (RFI_N), U12.22 (RFI_N)
/Sensors/R0_RFI_P: U9.4 (RFI_P), U12.21 (RFI_P)
/Sensors/R0_RFO: L4.2, U9.1 (RFO), U12.23 (RFO)
/Sensors/R0_XTA: U12.3 (XTA), Y4.3
/Sensors/R0_XTB: U12.4 (XTB), Y4.1
/Sensors/R1_DIO2: JP2.3 (B), U2.12 (DIO2); also elsewhere on the board
/Sensors/R1_RFI_N: U2.22 (RFI_N), U3.3 (RFI_N)
/Sensors/R1_RFI_P: U2.21 (RFI_P), U3.4 (RFI_P)
/Sensors/R1_RFO: L2.2, U2.23 (RFO), U3.1 (RFO)
/Sensors/R1_XTA: U2.3 (XTA), Y1.3
/Sensors/R1_XTB: U2.4 (XTB), Y1.1
GND: C1.2, C2.2, C3.2, C4.2, C5.2, C6.2, C7.2, C8.2, C9.2, C10.2, C11.2, C12.2, C13.2, C14.2, C16.2, C18.2, C19.2, C20.2, C21.2, C22.2, C31.2, C43.2, J1.2 (Ext), J2.2 (Ext), U1.6 (GND), U2.2 (GND), U2.5 (GND), U2.8 (GND), U2.20 (GND), U2.25 (EXP), U3.2 (GND), U3.5 (GND), U3.7 (GND), U3.9 (GND), U3.10 (GND), U4.1 (GND), U4.5 (SDO), U4.7 (GND), U5.2 (GND), U9.2 (GND), U9.5 (GND), U9.7 (GND), U9.9 (GND), U9.10 (GND), U10.2 (GND), U12.2 (GND), U12.5 (GND), U12.8 (GND), U12.20 (GND), U12.25 (EXP), Y1.2, Y1.4, Y4.2, Y4.4; also elsewhere on the board
unnamed: C15.2, C18.1, L5.2
unnamed: C17.2, C22.1, L1.2
unnamed: C31.1, J1.1 (In), L1.1
unnamed: C16.1, J2.1 (In), L5.1
unnamed: JP1.2 (C), R7.2
unnamed: JP2.2 (C), R3.2
unnamed: L3.1, U2.9 (DCC_SW)
unnamed: C6.1, L3.2, U2.7 (VREG)
unnamed: C4.1, C5.1, L2.1, U2.24 (VR_PA)
unnamed: U3.6 (SW_RFI), U5.3 (RF2)
unnamed: U3.8 (SW_RFO), U5.1 (RF1)
unnamed: C15.1, U5.5 (RFC)
unnamed: C19.1, R2.1, U5.6 (V1)
unnamed: C20.1, R3.1, U5.4 (V2)
unnamed: U9.8 (SW_RFO), U10.1 (RF1)
unnamed: U9.6 (SW_RFI), U10.3 (RF2)
unnamed: C17.1, U10.5 (RFC)
unnamed: C21.1, R8.1, U10.6 (V1)
unnamed: C12.1, R7.1, U10.4 (V2)
unnamed: L7.1, U12.9 (DCC_SW)
unnamed: C43.1, L7.2, U12.7 (VREG)
unnamed: C10.1, C11.1, L4.1, U12.24 (VR_PA)

Notes on the sheet:
ANTENNA MATCHING/SWITCH LORA
Condition
Tx to ANT
SX1262
RF2
RF1
Rx to ANT
I2C: 0x76
ICM-42670-P

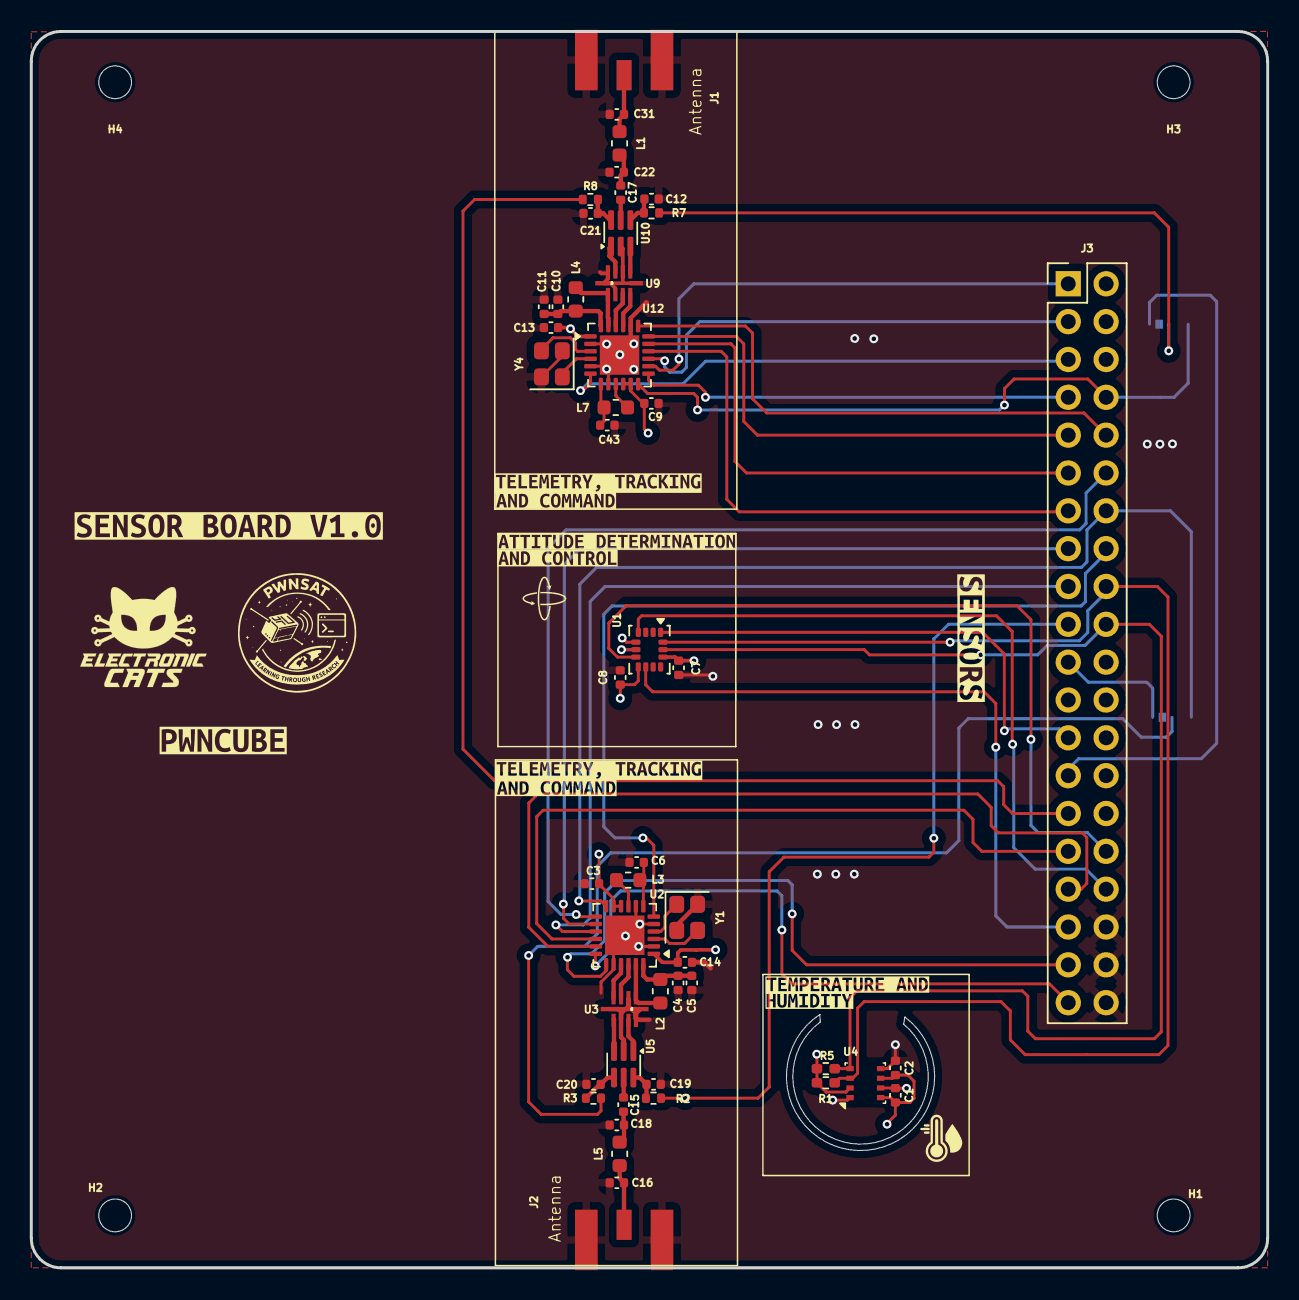
[picture p23: board Sensor_Board.kicad_pcb from above]

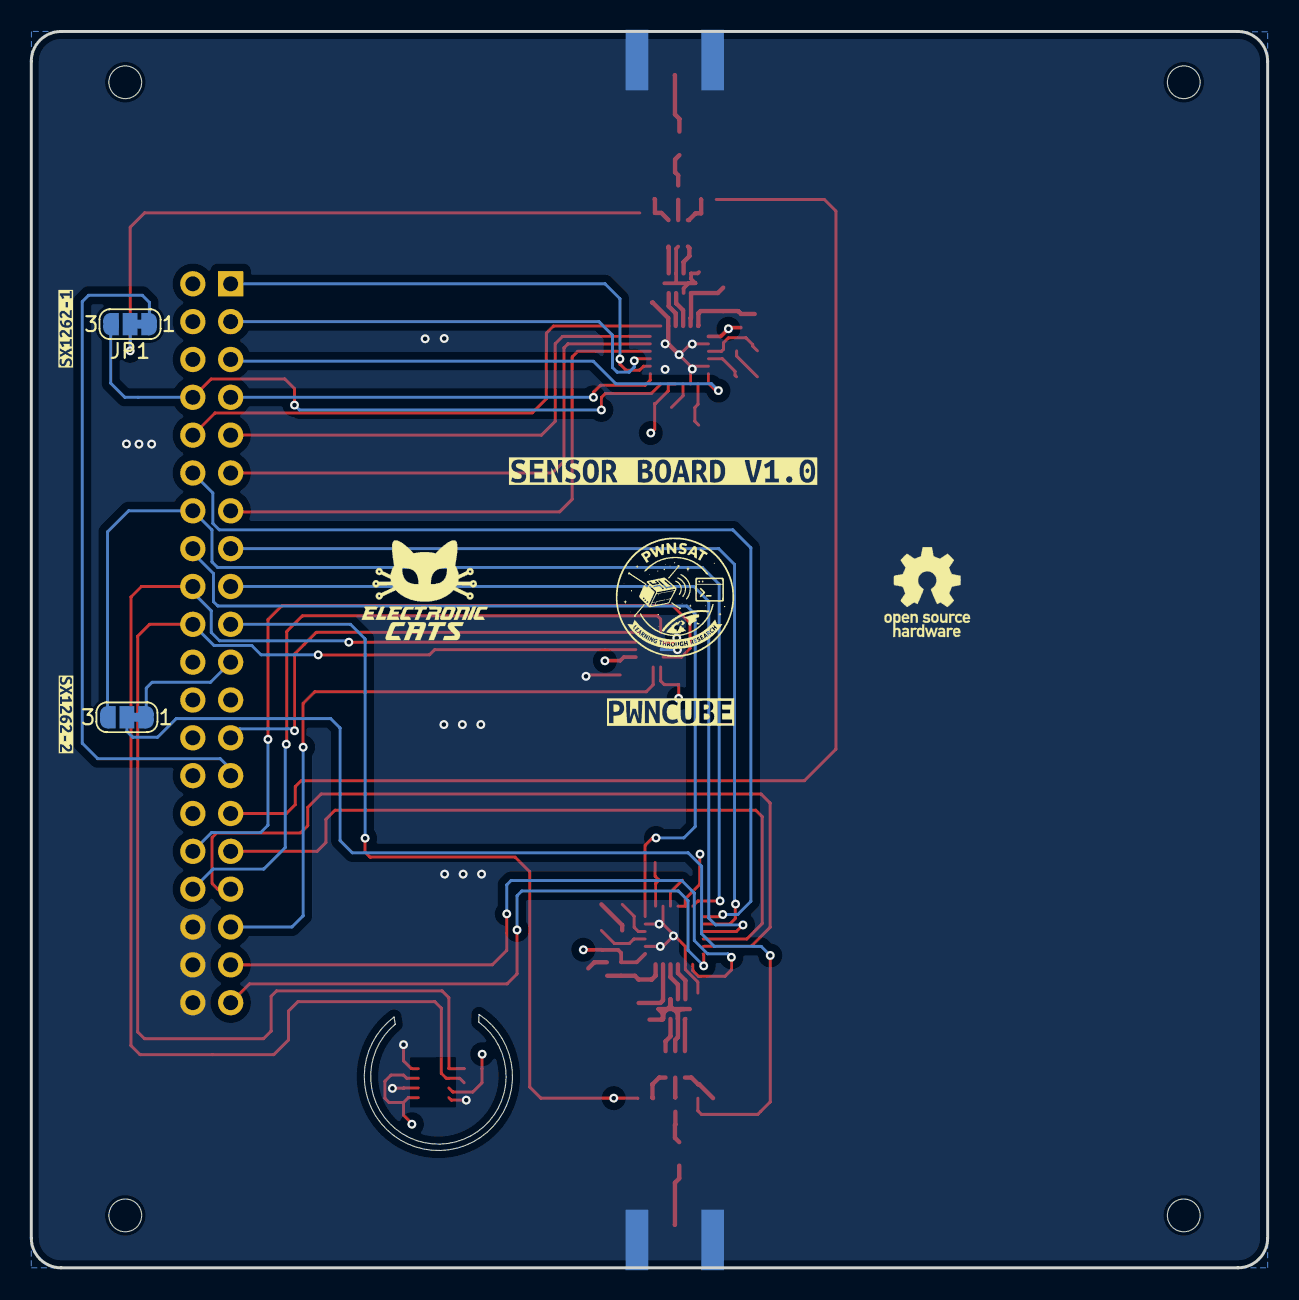
[picture p24: board Sensor_Board.kicad_pcb from below]

Board: 4 copper layers, 83.0 x 83.0 mm, 70 parts (6 on the bottom side), 62 nets.

Other parts of the board:
H1, H2, H3, H4: MountingHole; MountingHole_2.2mm_M2
kibuzzard-69860F52: G***; kibuzzard-69860F52
kibuzzard-69860F65: G***; kibuzzard-69860F65
kibuzzard-69866AEC: G***; kibuzzard-69866AEC
kibuzzard-69866B09: G***; kibuzzard-69866B09
kibuzzard-698518BF, kibuzzard-698518BF#2: G***; kibuzzard-698518BF
kibuzzard-698518EC, kibuzzard-698518EC#2: G***; kibuzzard-698518EC
kibuzzard-698668F8: G***; kibuzzard-698668F8
kibuzzard-698669D4, kibuzzard-698669D4#2: G***; kibuzzard-698669D4
kibuzzard-698669E3, kibuzzard-698669E3#2: G***; kibuzzard-698669E3
kibuzzard-6985197E: G***; kibuzzard-6985197E
kibuzzard-69866904: G***; kibuzzard-69866904
