ElectronicCats/PWNCUBE/hardware/Battery_Board/Battery_Board.kicad_pcb

## KiCad design hardware/Battery_Board/Battery_Board.kicad_pcb (2026-02-09)

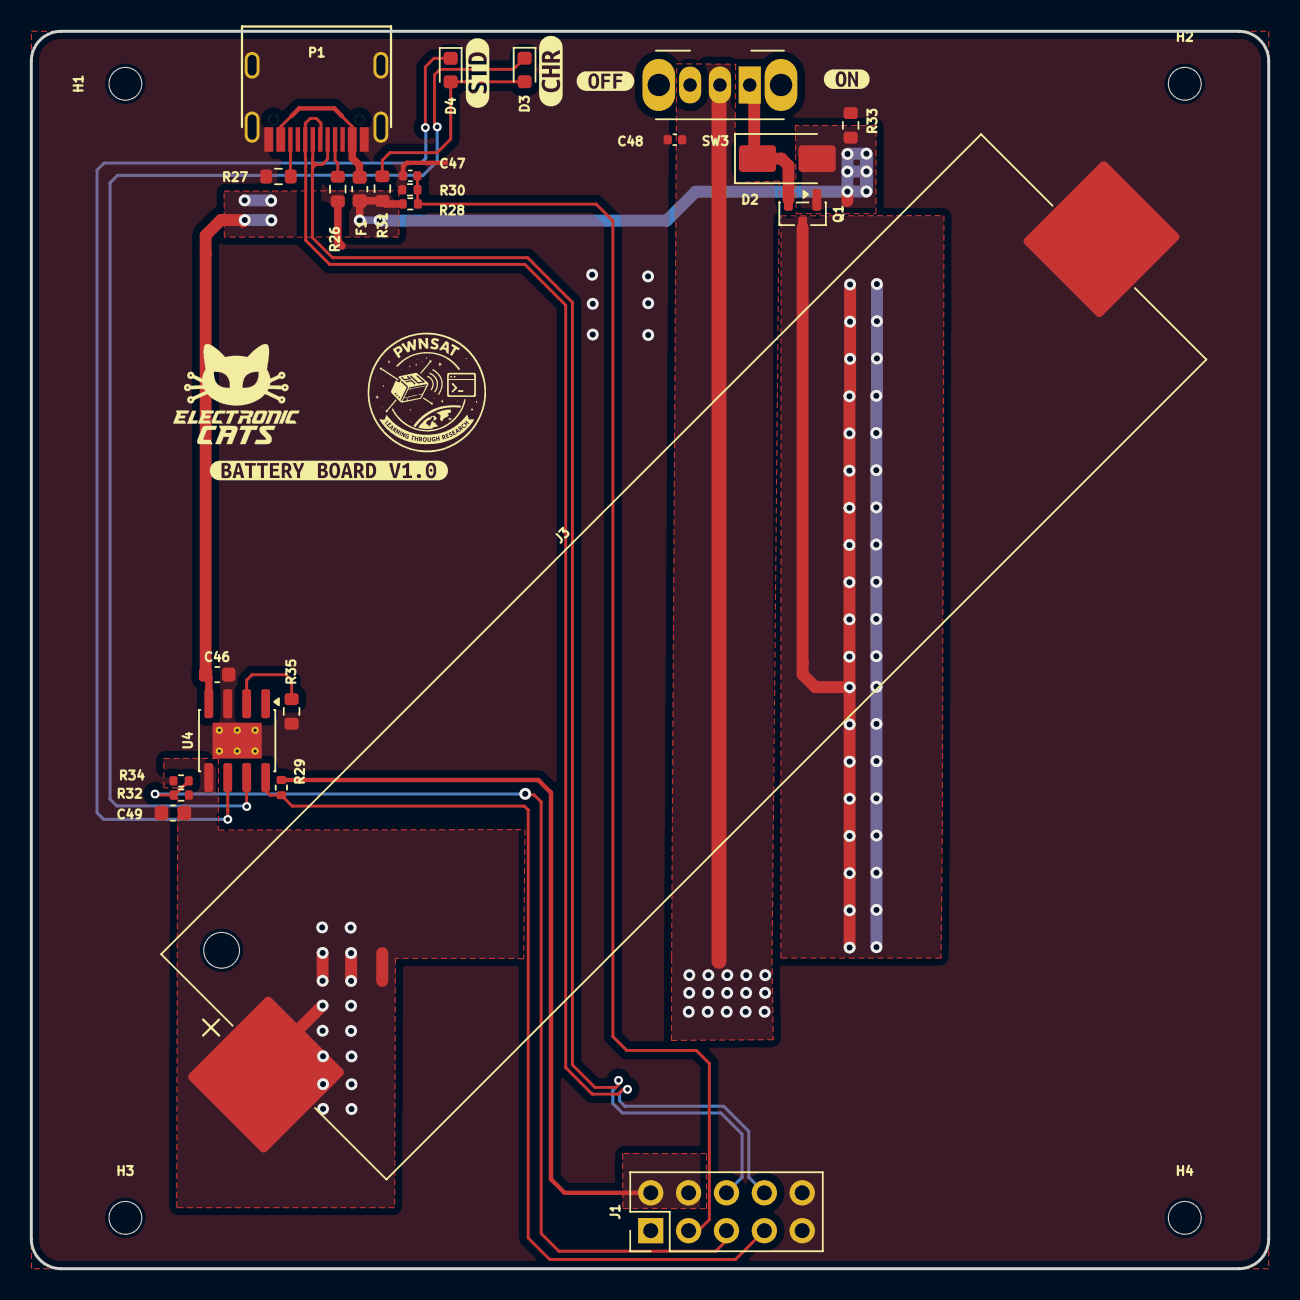
[picture p25: board Battery_Board.kicad_pcb from above]

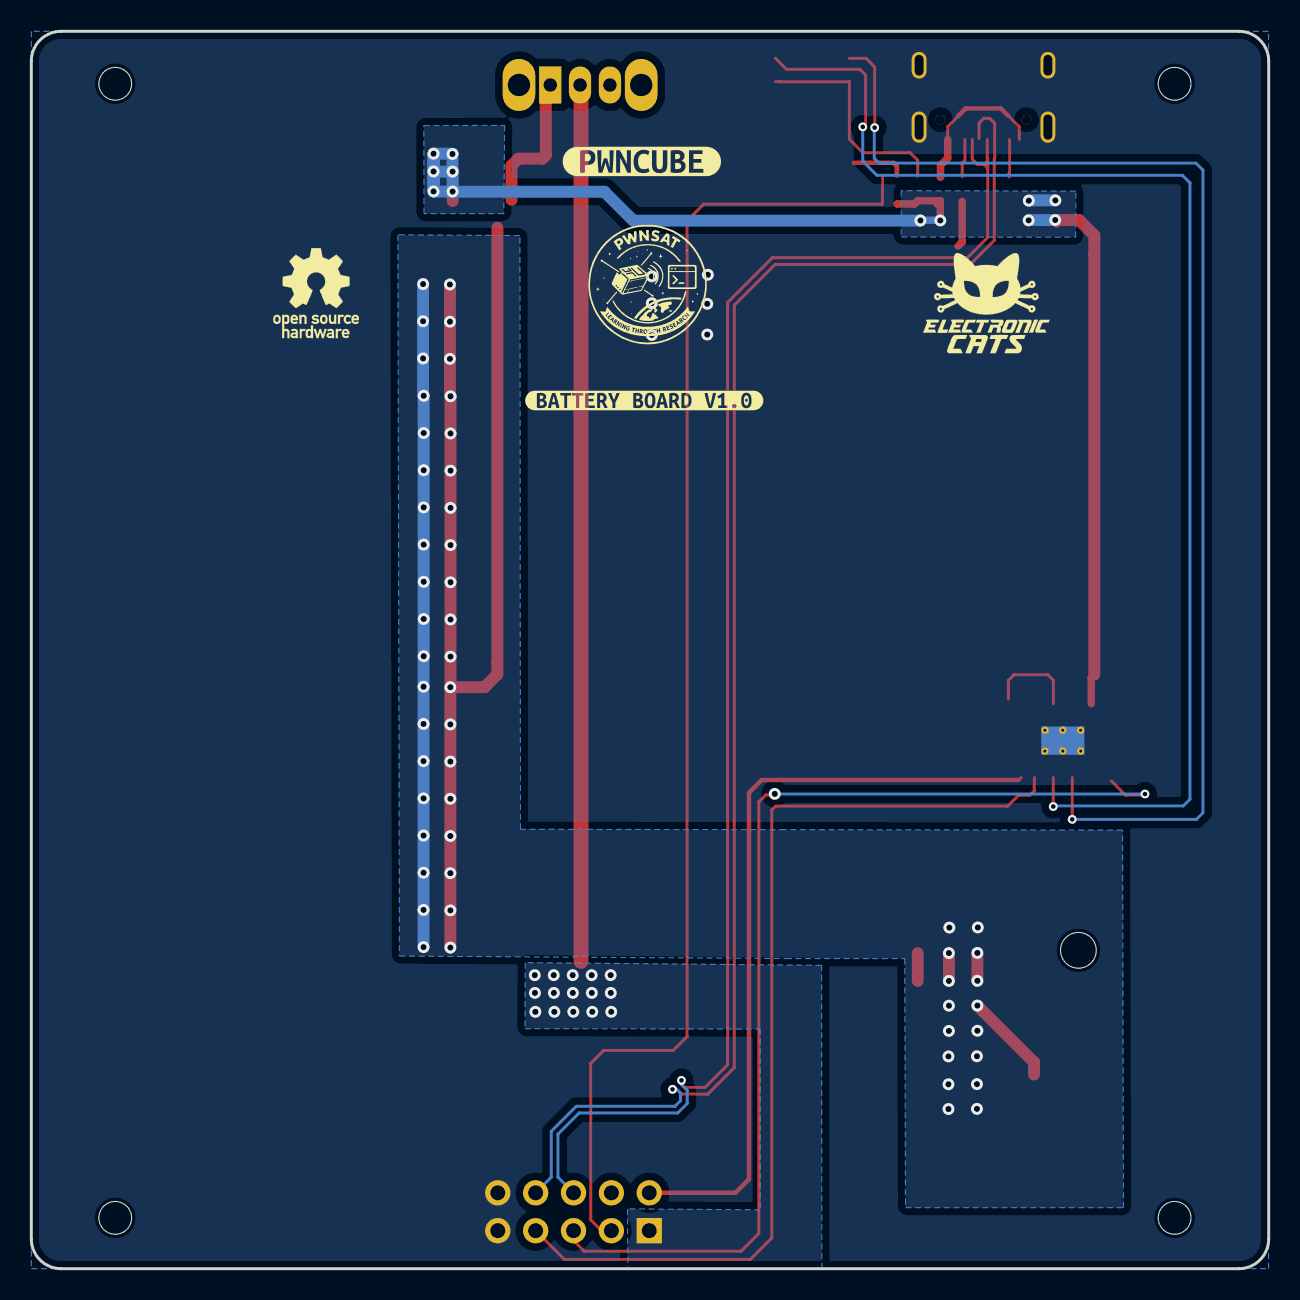
[picture p26: board Battery_Board.kicad_pcb from below]

Board: 2 copper layers, 83.0 x 83.0 mm, 35 parts (2 on the bottom side), 18 nets.

Parts:
C46, C49: 10uF; C_0603_1608Metric
C47: 100nF; C_0402_1005Metric
C48: 10uF; C_0402_1005Metric
D2: SS34; D_SMA
D3, D4: LED; LED_0603_1608Metric
F1: 2A; Fuse_0603_1608Metric
H1, H2, H3, H4: MountingHole; MountingHole_2.2mm_M2
J1: Source; PinHeader_2x05_P2.54mm_Vertical
J3: Battery; BatteryHolder_Keystone_1042_1x18650
P1: USB_C_Plug_USB2.0; C393939
Q1: DMG3415U-7; SOT-23
R26, R27: 5k1; R_0603_1608Metric
R28, R29, R34: 10K; R_0402_1005Metric
R30: 18k; R_0402_1005Metric
R31, R35: 2K; R_0603_1608Metric
R32: 10.7K; R_0402_1005Metric
R33: 100K; R_0603_1608Metric
SW3: ON; SW_Slide_SPDT_Angled_CK_OS102011MA1Q
U4: TP4056; SOIC-8-1EP_3.9x4.9mm_P1.27mm_EP2.41x3.3mm_ThermalVias
kibuzzard-698511AF: G***; kibuzzard-698511AF
kibuzzard-698511C2: G***; kibuzzard-698511C2
kibuzzard-6985125C: G***; kibuzzard-6985125C
kibuzzard-69851248, kibuzzard-69851248#2: G***; kibuzzard-69851248
kibuzzard-69851454: G***; kibuzzard-69851454
kibuzzard-69851473: G***; kibuzzard-69851473

Connections:
+3.3V: J1.2, J1.4, R29.1
+BATT: C49.1, J3.1, Q1.3 (D), R32.1, U4.5 (BAT)
/Batt_Connector/2_DN: J1.6, P1.A7 (D-)
/Batt_Connector/2_DP: J1.8, P1.A6 (D+)
/Batt_Connector/Battery: J1.5, R32.2, R34.1
/Batt_Connector/Enable: J1.7, R29.2, U4.8 (CE)
/Batt_Connector/USB_DET: C47.1, J1.3, R28.1, R30.1
GND: C46.1, C47.2, C48.2, C49.2, J1.9, J1.10, J3.2, P1.A1 (GND), P1.S1 (SHIELD), R26.1, R27.1, R30.2, R33.2, R34.2, R35.2, U4.3 (GND), U4.9 (EPAD)
unnamed: D2.1 (K), Q1.2 (S), SW3.1 (A)
unnamed: D3.2 (A), D4.2 (A), R31.2
unnamed: D3.1 (K), U4.7 (~CHRG)
unnamed: D4.1 (K), U4.6 (~STDBY)
unnamed: F1.1, P1.A4 (VBUS)
unnamed: P1.A5 (CC), R26.2
unnamed: P1.B5 (VCONN), R27.2
unnamed: R35.1, U4.2 (PROG)
VBUS: C46.2, D2.2 (A), F1.2, Q1.1 (G), R28.2, R31.1, R33.1, U4.4 (V_{CC})
VCC: C48.1, J1.1, SW3.2 (B)
