ElectronicCats/PWNCUBE/(commit log)

2026-01-12 feat(Hw): Started_sch
    [PWNSAT.kicad_pcb, PWNSAT.kicad_sch, power_supply.kicad_sch, sensor.kicad_sch, untitled.kicad_sch]
2026-01-13 feat(Hw): Added_BOM
    [power_supply.kicad_sch, sensor.kicad_sch, untitled.kicad_sch]
2026-01-15 feat(Hw):Sch_Updated
    Pending_Sensor_Connector
    [Inputs_Connectors.kicad_sch, PWNSAT.kicad_sch, Sensor_Board.kicad_pcb, Sensor_Board.kicad_sch, Sensors.kicad_sch, USB.kicad_sch, power_supply.kicad_sch, sensor.kicad_sch]
2026-01-20 feat(Hw):Update_Floorplan_Init_First _route
    Pending_Battery_Type
    [PWNSAT.kicad_pcb, sensor.kicad_sch, untitled.kicad_sch]
2026-01-23 feat(Hw):Update_Battery_Sch_And_Sensors_And_PWNCube
    pending_Outputs_connectors
    [Batt_Connector.kicad_sch, Battery_Board.kicad_sch, Inputs_Connectors.kicad_sch, PWNSAT.kicad_sch, Source_Connector.kicad_sch, USB.kicad_sch, USB_Selector.kicad_sch, power_supply.kicad_sch]
2026-02-03 feat(Hw):Route_UpdatedPWNcube_
    Pending_3v3
    [PWNSAT.kicad_pcb, USB_Selector.kicad_sch, sensor.kicad_sch]
2026-02-04 feat(Hw):Boards_Updated
    Pending_Sensors_Board
    [Battery_Board.kicad_pcb, PWNSAT.kicad_pcb, PWNSAT.kicad_sch, Sensors.kicad_sch, sensor.kicad_sch, untitled.kicad_sch]
2026-02-09 feat(Hw):BoM´s_Updated
    [Batt_Connector.kicad_sch, Battery_Board.kicad_pcb, PWNSAT.kicad_pcb, Sensor_Board.kicad_pcb, Source_Connector.kicad_sch, USB.kicad_sch, USB_Selector.kicad_sch, power_supply.kicad_sch]
2026-03-13 feat(Hw):Route_Updated
    Pending review
    [PWNSAT.kicad_pcb]
2026-03-17 Feat(Hw): Change to 4-layer
    [PWNSAT.kicad_pcb, Source_Connector.kicad_sch]
2026-04-01 Updated for Arsenal USA
    Updated for Arsenal USA
    [Tapa-Body.stl]
